mfauzansyarif/ugv-robot/dokumentasi/image (3).png

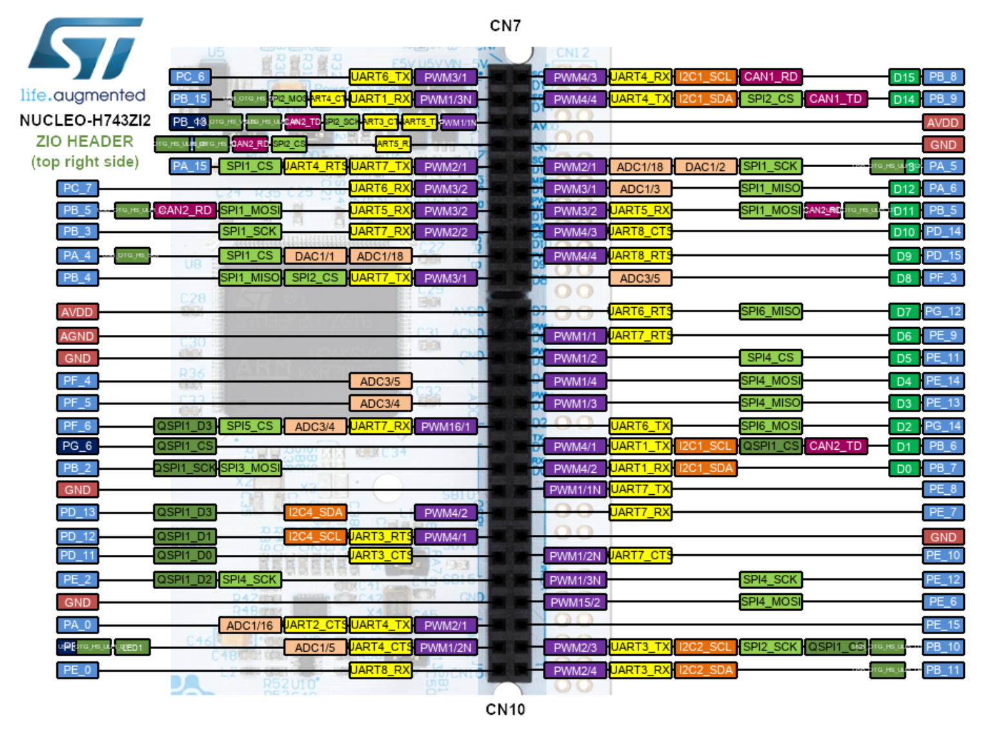
dokumentasi/image (3).png
