mfauzansyarif/ugv-robot/dokumentasi/image (2).png

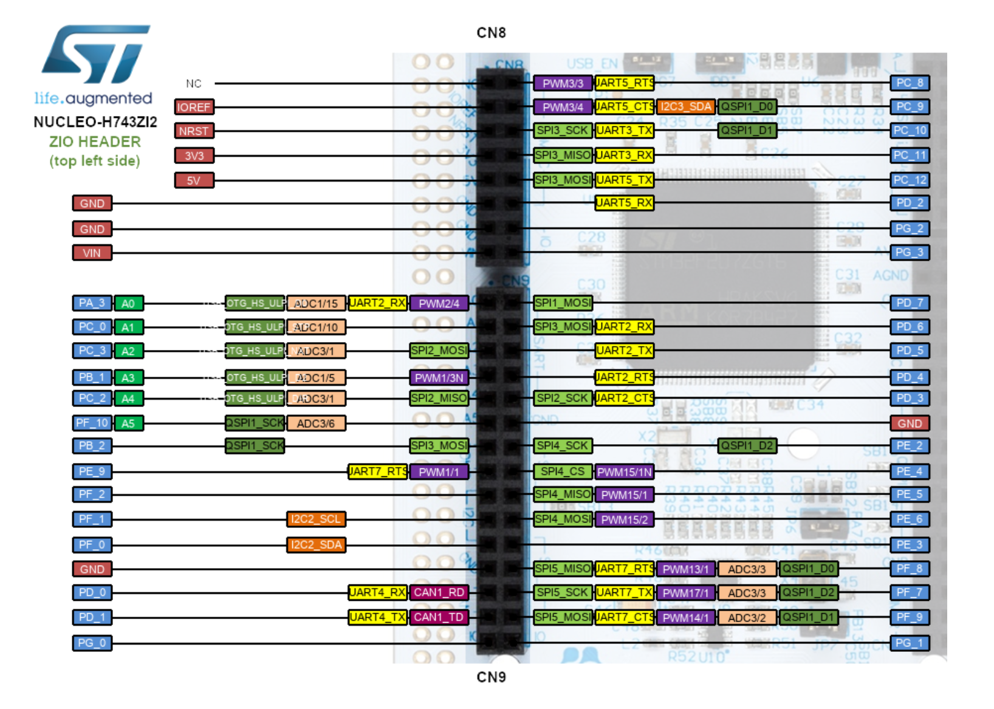
dokumentasi/image (2).png
