mfauzansyarif/ugv-robot/Hardware/GCS/LAYOUT PANEL ROBOT TERBARU.pptx

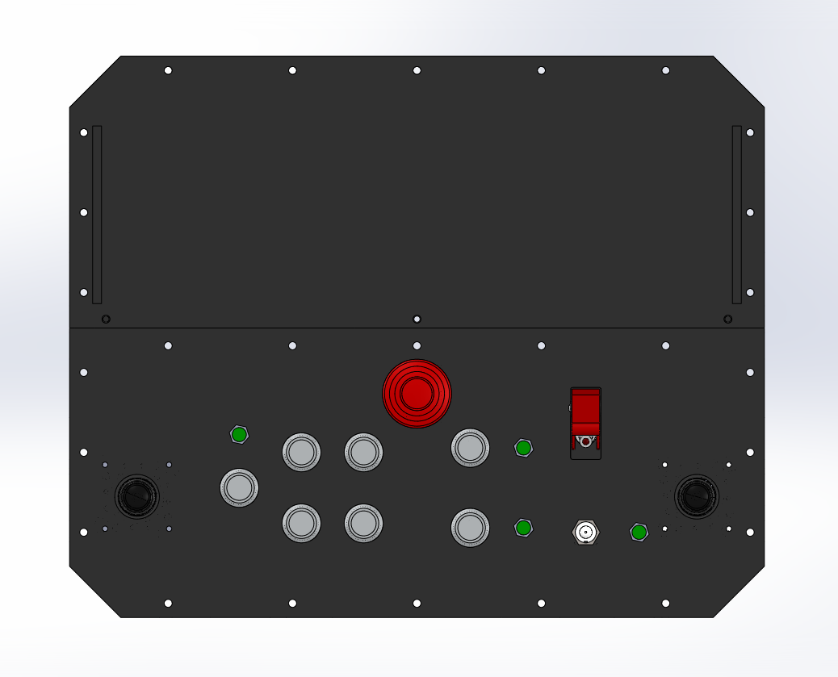
[picture p3: figure]

PENGHENTIAN DARURAT

INDIKATOR LRF

AKTIVASI & INDIKATOR DAYA

PERGERAKAN ROBOT

PERGERAKAN KAMERA

MODE MENGEMUDI + INDIKATOR

AKTIVASI LRF

PENGATURAN ZOOM

PENGATURAN FOKUS

MODE PEMOSISIAN + INDIKATOR

AKTIVASI PENERANGAN

## Slide 2

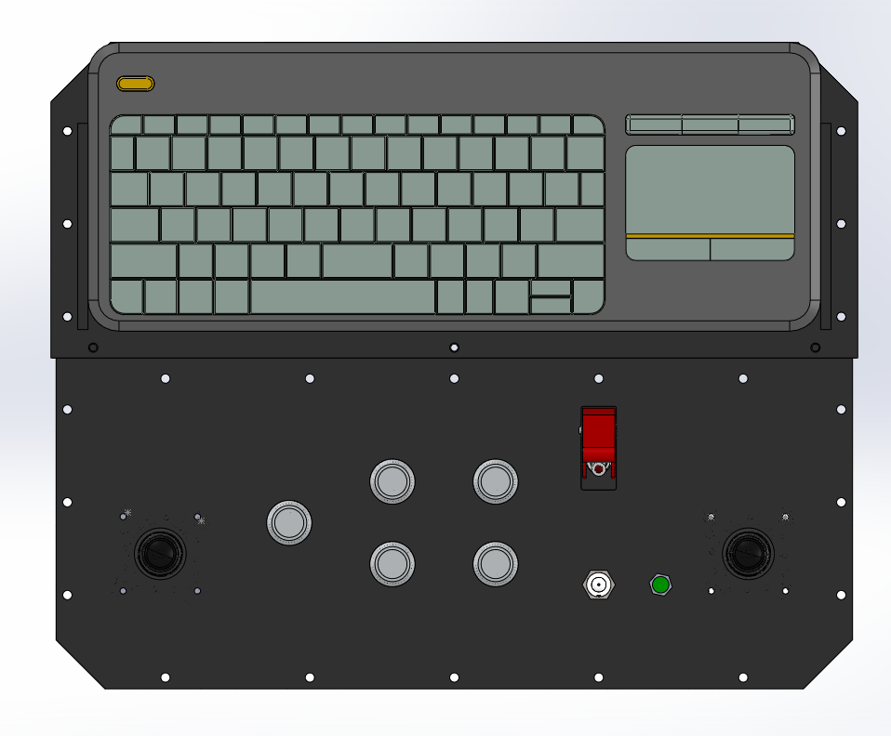
[picture p4: figure]

AKTIVASI & INDIKATOR DAYA

PERGERAKAN ROBOT

AKTIVASI LRF

PENGATURAN ZOOM

PENGATURAN FOKUS

PERGERAKAN KAMERA

AKTIVASI PENERANGAN
