mfauzansyarif/ugv-robot/dokumentasi/Gambar 1.pdf

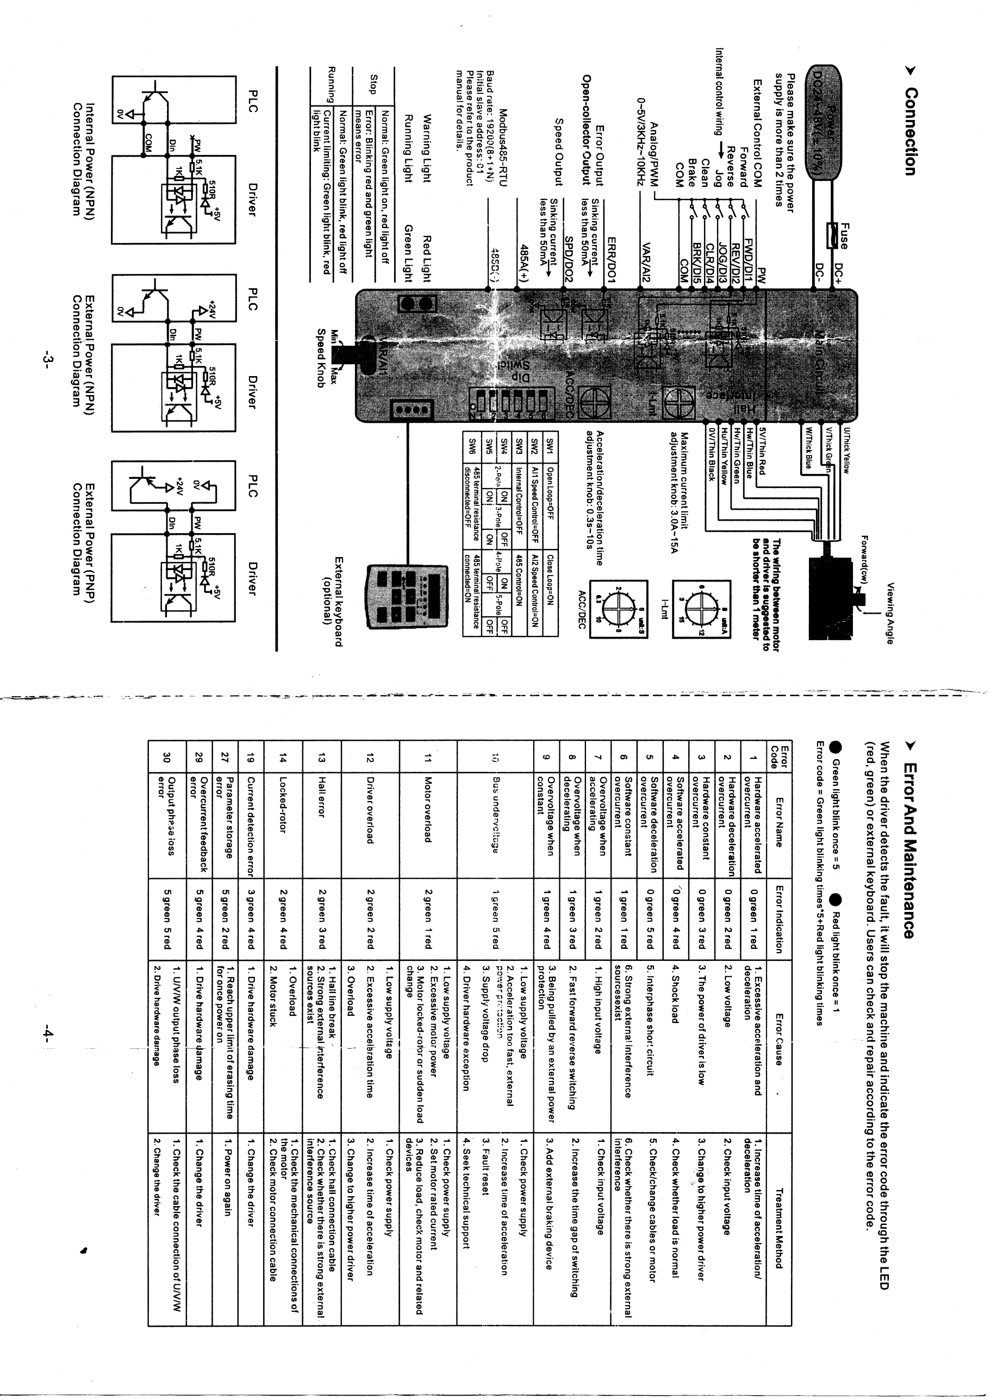
[picture p5: page 1]
