mfauzansyarif/ugv-robot/dokumentasi/Gambar 2.pdf

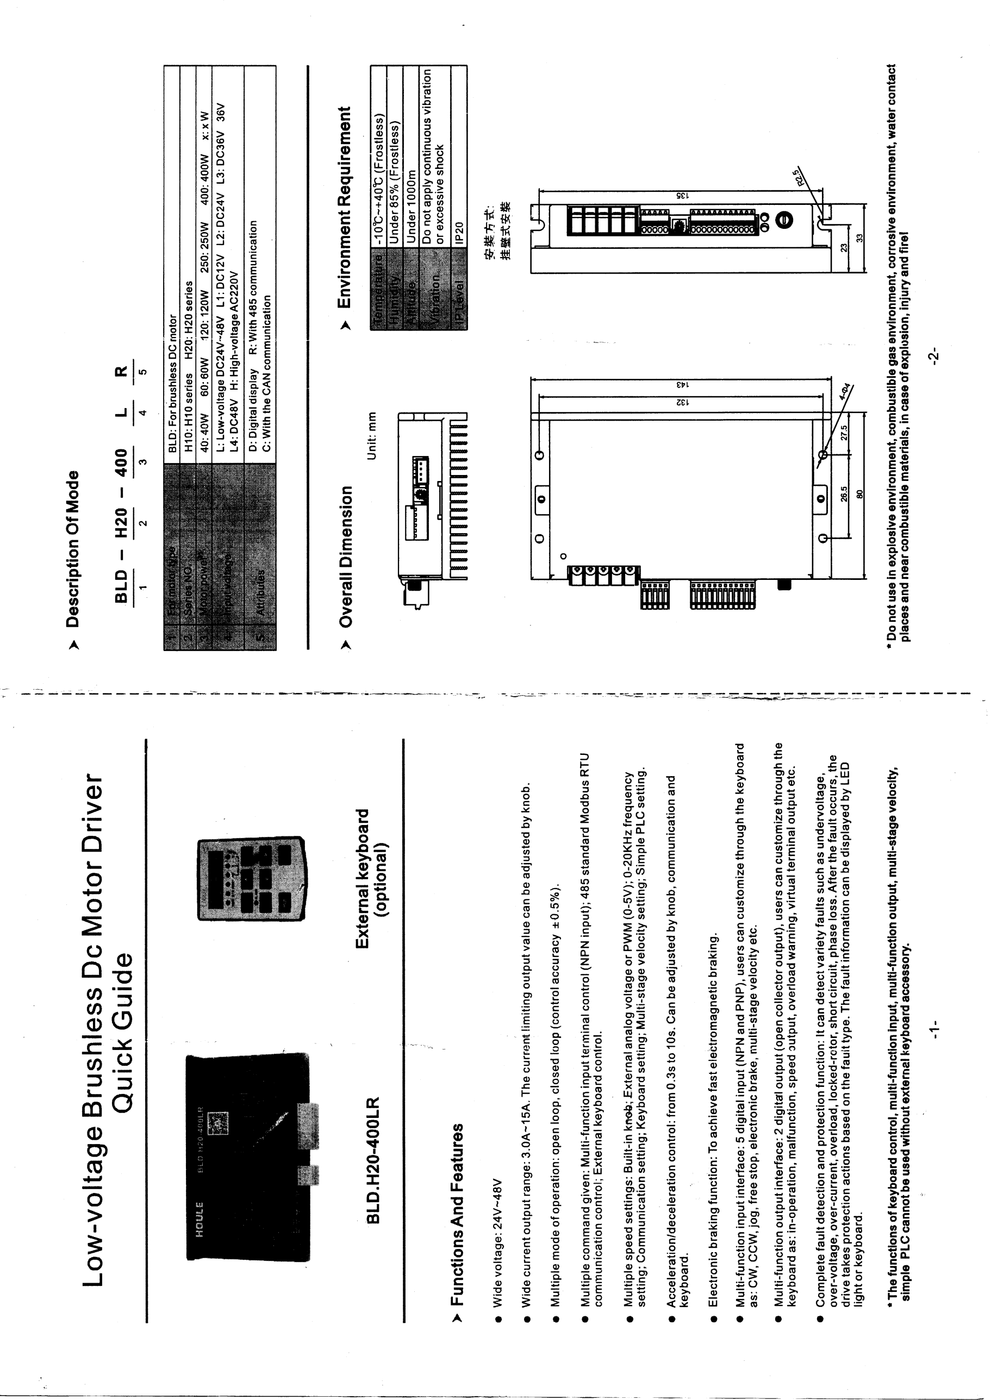
[picture p6: page 1]
