mfauzansyarif/ugv-robot/dokumentasi/Gambar 3.pdf

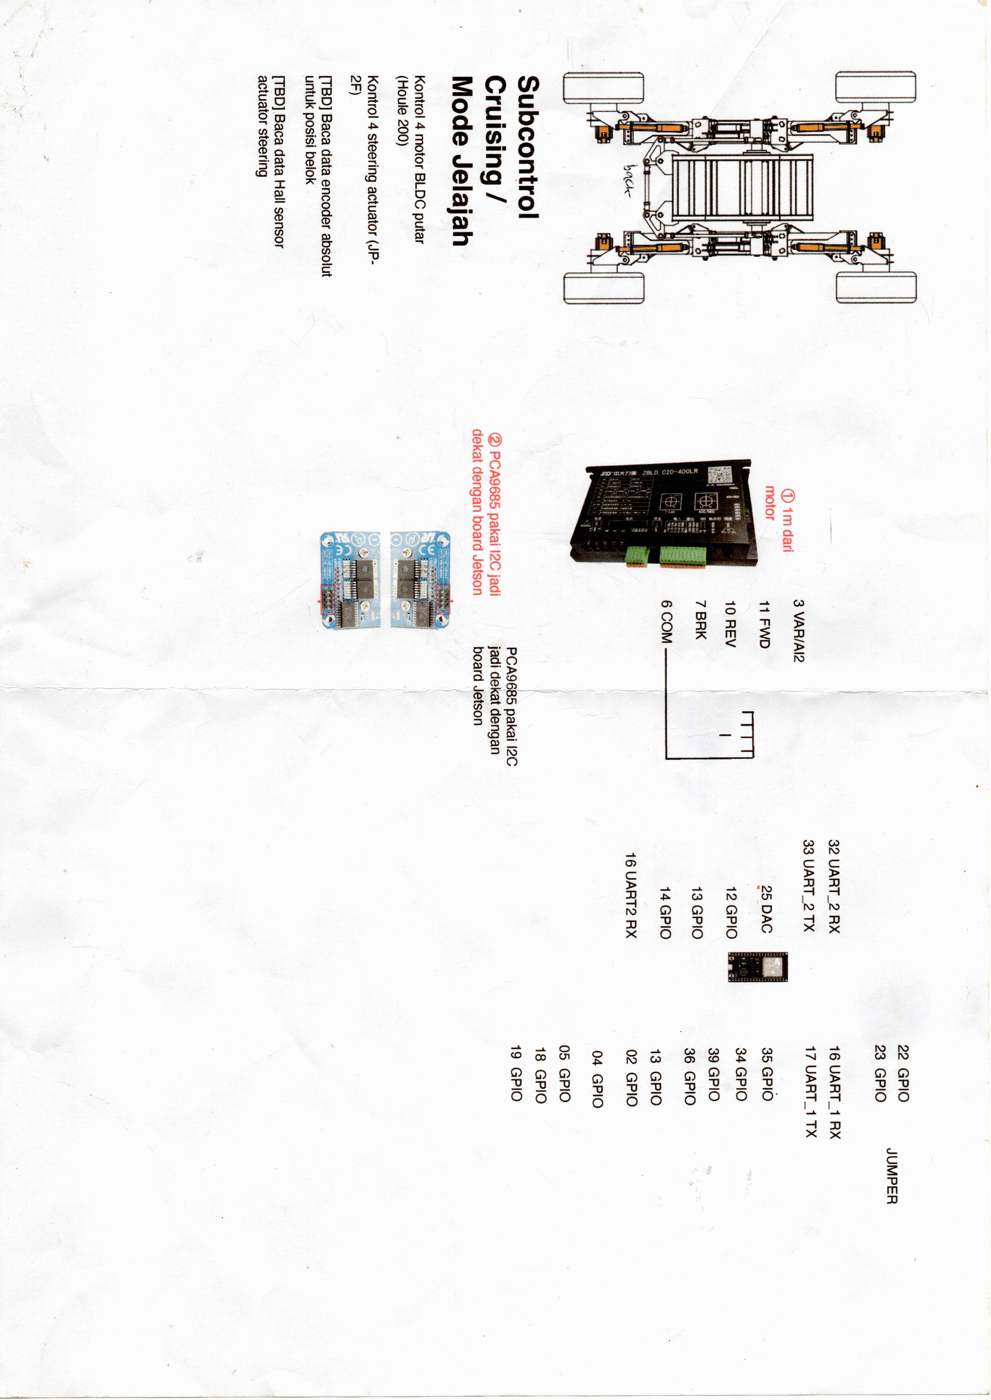
[picture p7: page 1]
