mfauzansyarif/ugv-robot/dokumentasi/1.jpeg

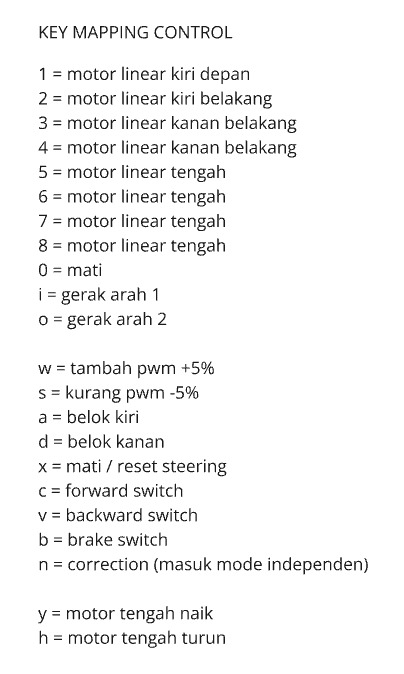
dokumentasi/1.jpeg
