mfauzansyarif/ugv-robot/dokumentasi/2.jpeg

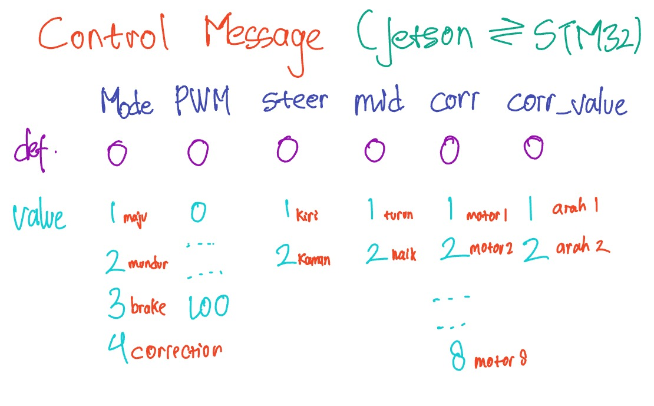
dokumentasi/2.jpeg
