mfauzansyarif/ugv-robot/dokumentasi/3.jpeg

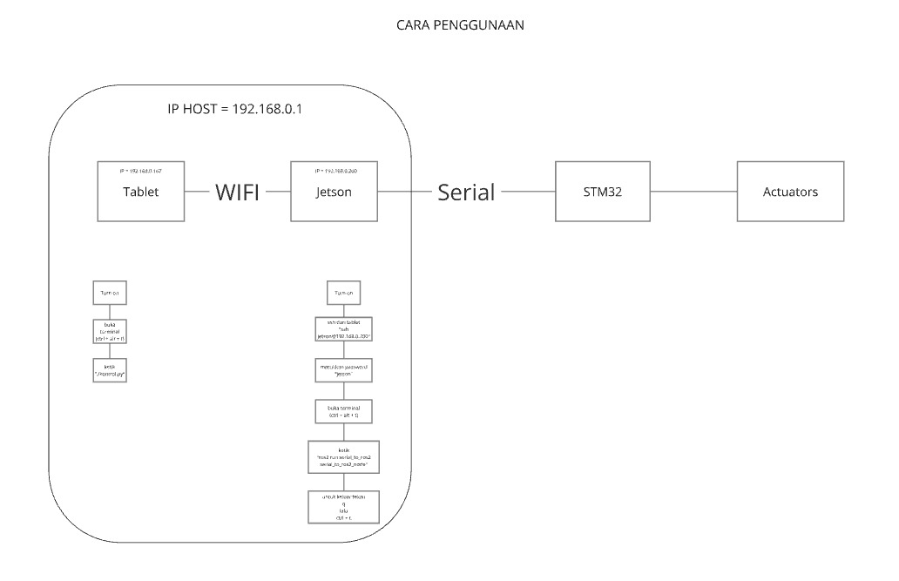
dokumentasi/3.jpeg
