mfauzansyarif/ugv-robot/dokumentasi/4.jpeg

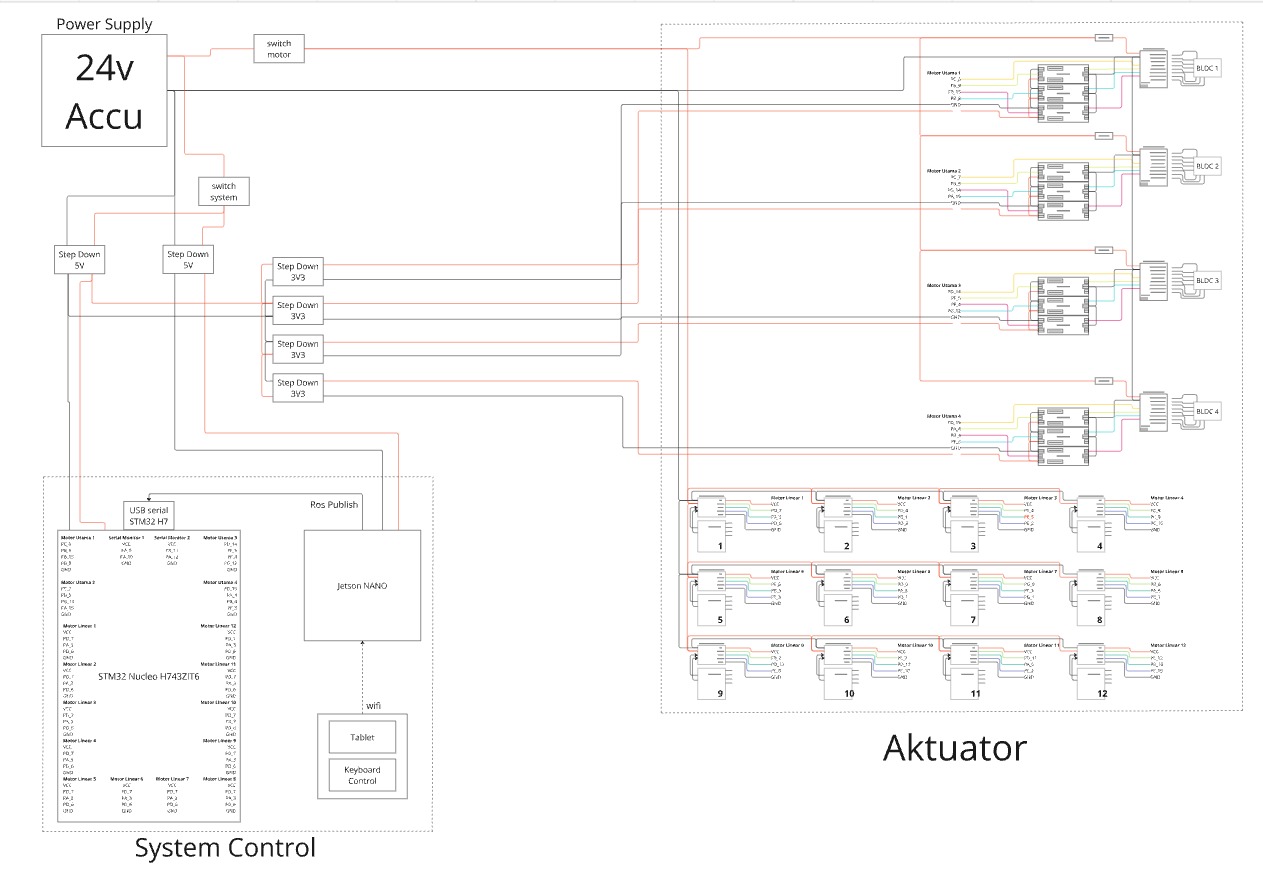
dokumentasi/4.jpeg
