mfauzansyarif/ugv-robot/dokumentasi/5.jpeg

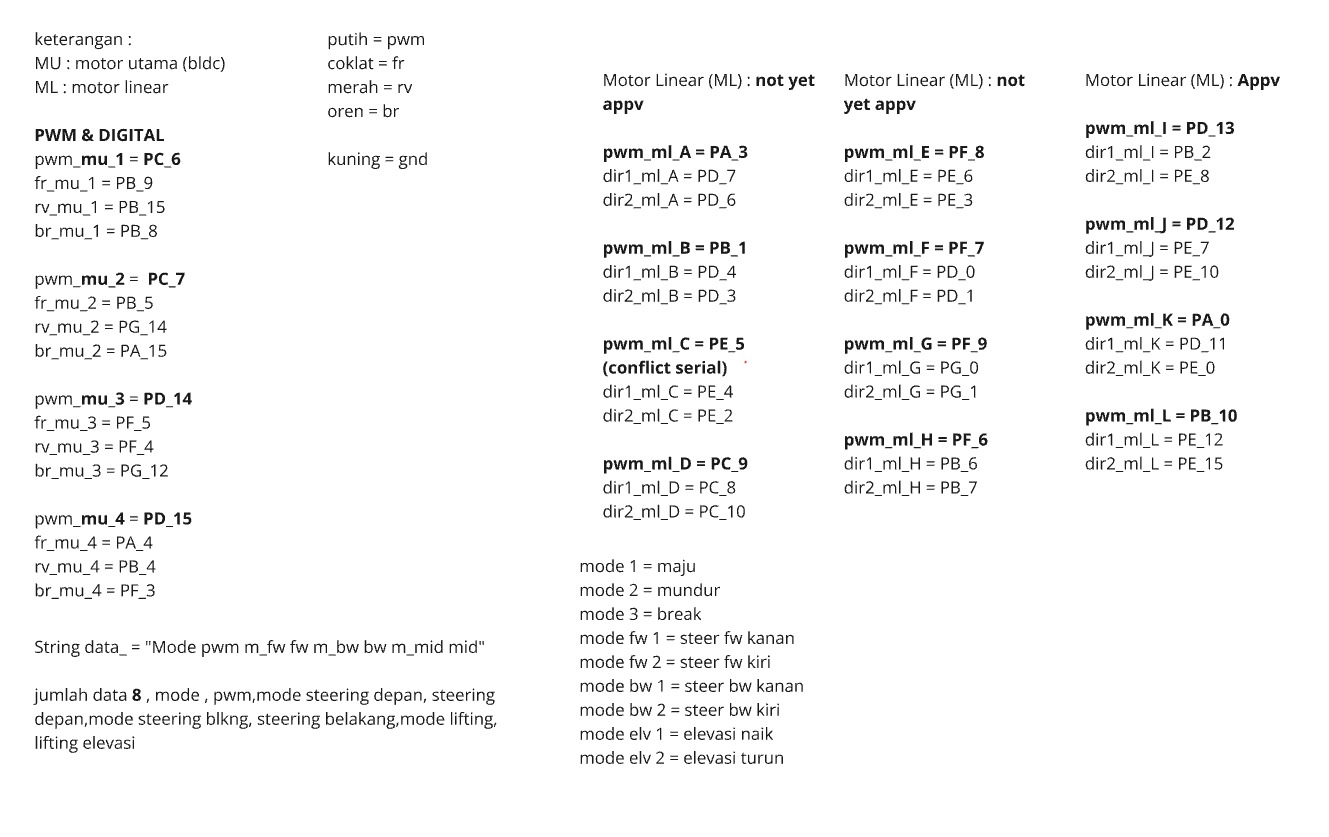
dokumentasi/5.jpeg
