mfauzansyarif/ugv-robot/Dokumentasi/Block Diagram.png

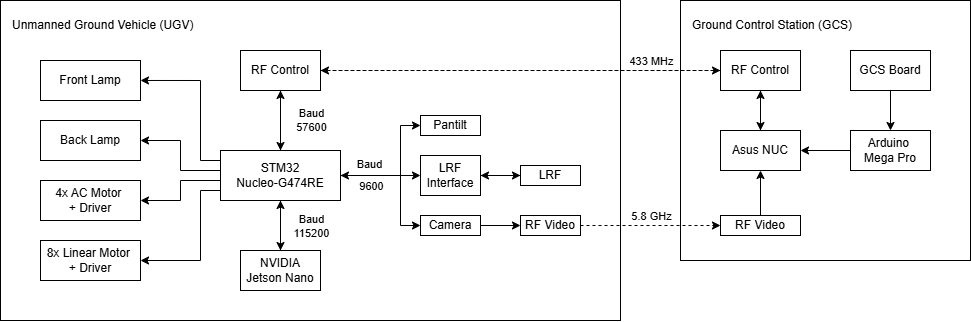
Dokumentasi/Block Diagram.png
