mfauzansyarif/ugv-robot/dokumentasi/board.png

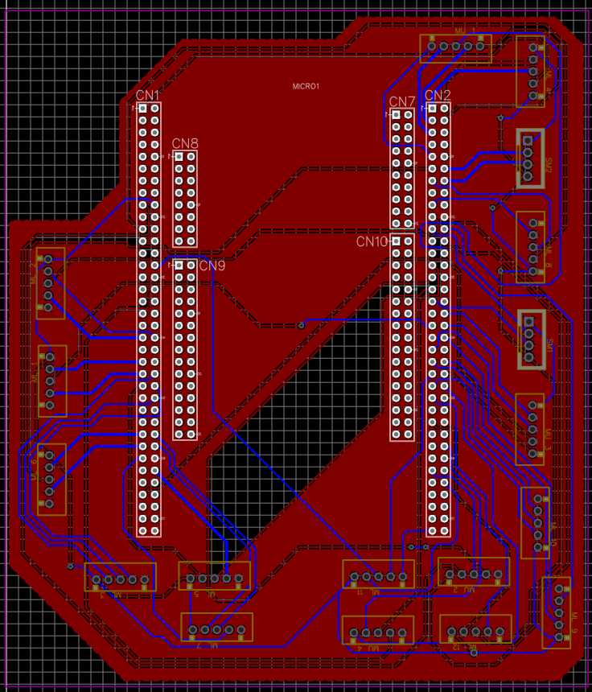
dokumentasi/board.png
