mfauzansyarif/ugv-robot/dokumentasi/boardrot.png

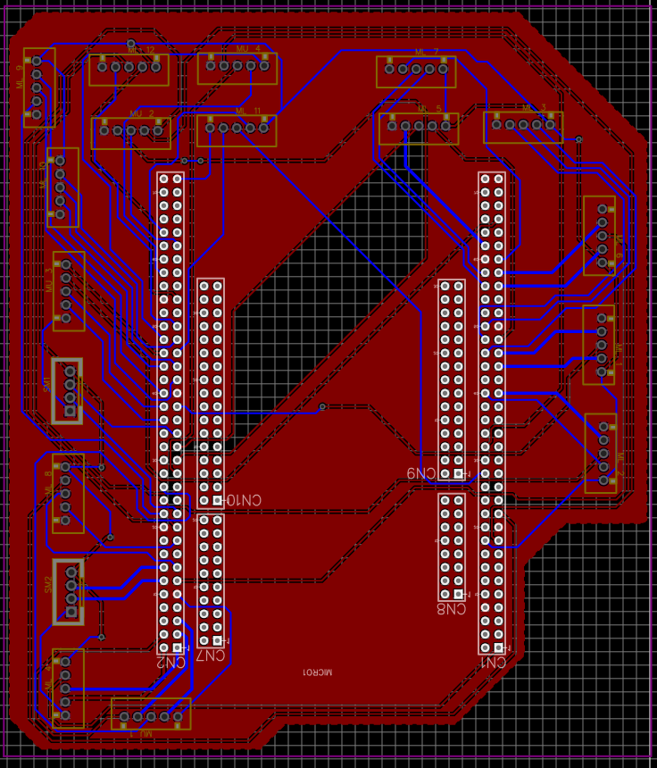
dokumentasi/boardrot.png
