mfauzansyarif/ugv-robot/dokumentasi/Finished/1.jpg

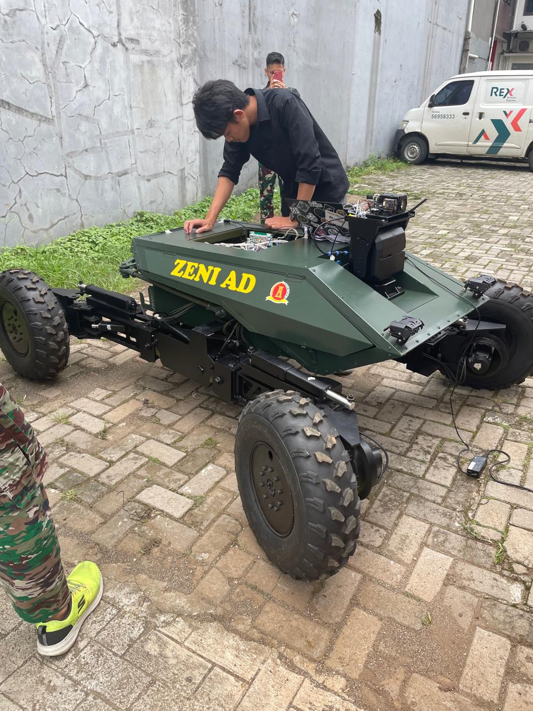
dokumentasi/Finished/1.jpg
