mfauzansyarif/ugv-robot/dokumentasi/Finished/2.jpg

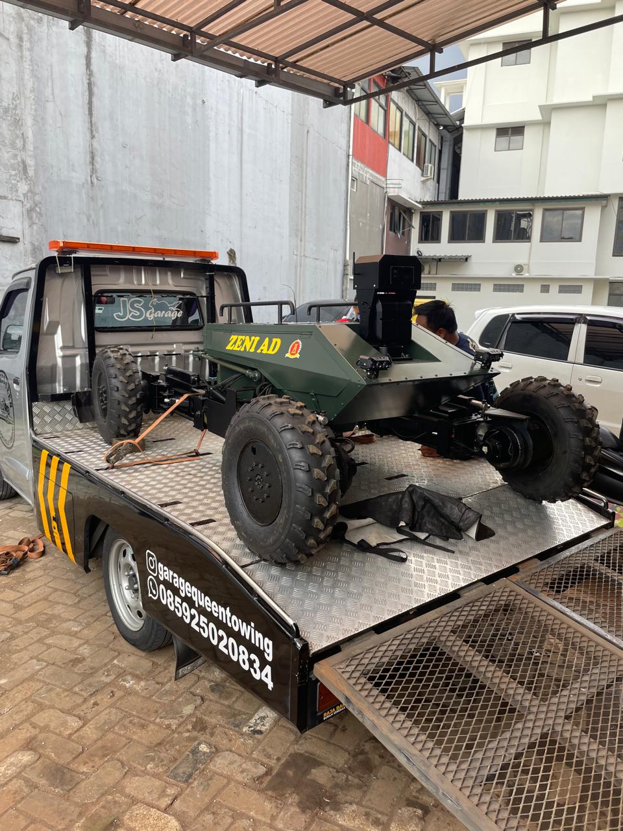
dokumentasi/Finished/2.jpg
