mfauzansyarif/ugv-robot/dokumentasi/Finished/3.jpg

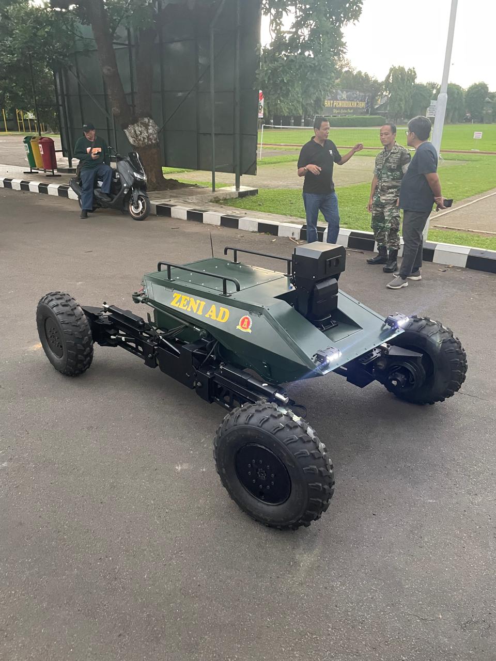
dokumentasi/Finished/3.jpg
