mfauzansyarif/ugv-robot/dokumentasi/Finished/Tampilan GCS.jpg

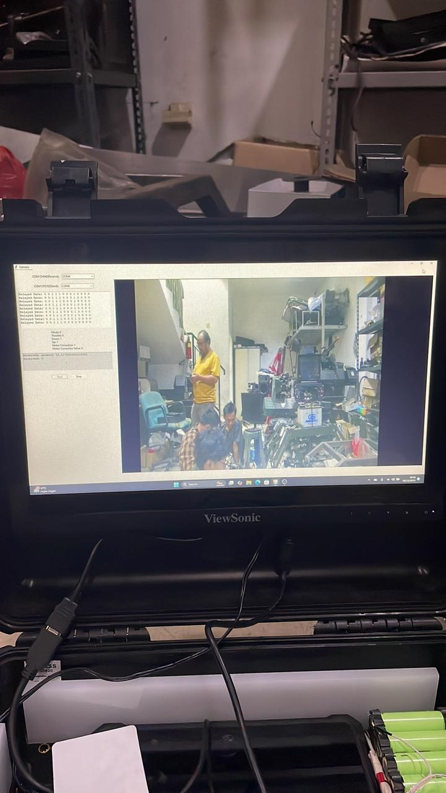
dokumentasi/Finished/Tampilan GCS.jpg
