mfauzansyarif/ugv-robot/dokumentasi/Finished/Video Channel.jpg

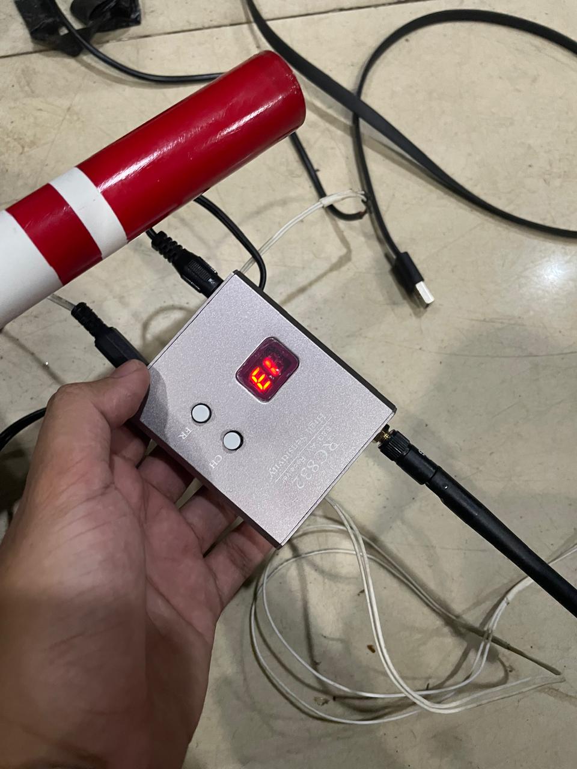
dokumentasi/Finished/Video Channel.jpg
