mfauzansyarif/ugv-robot/dokumentasi/flowchart ros.jpeg

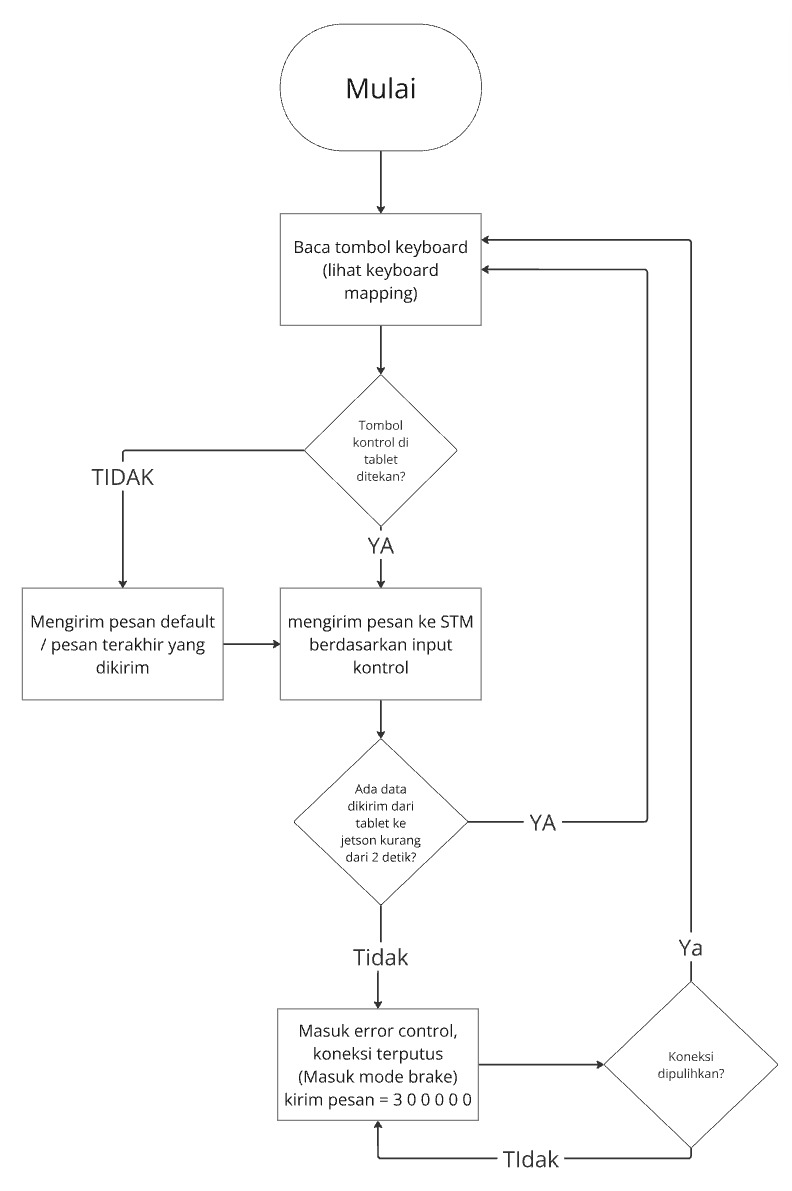
dokumentasi/flowchart ros.jpeg
