mfauzansyarif/ugv-robot/dokumentasi/flowchart_micro.jpeg

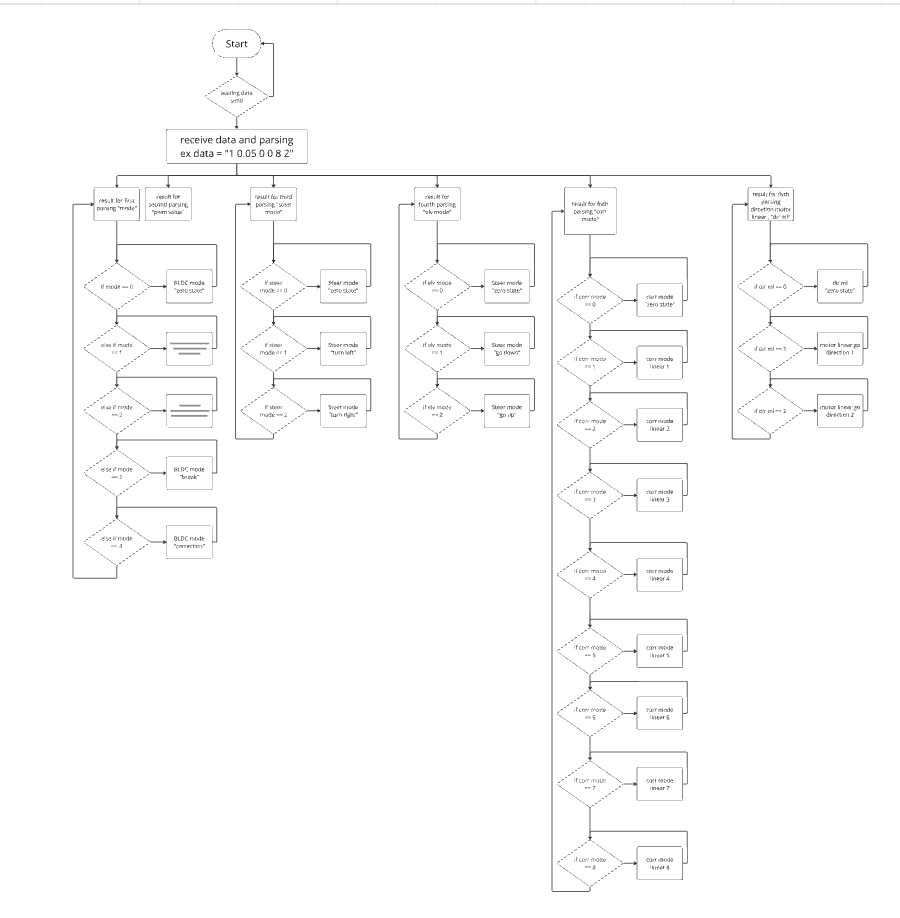
dokumentasi/flowchart_micro.jpeg
