mfauzansyarif/ugv-robot/dokumentasi/image (1).png

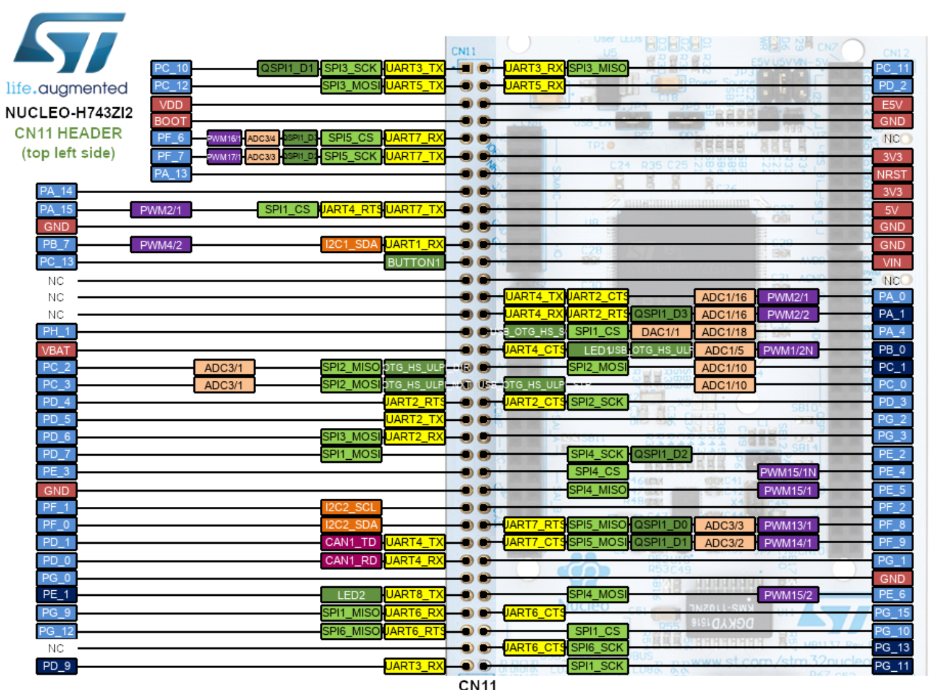
dokumentasi/image (1).png
