mfauzansyarif/ugv-robot/dokumentasi/image (4).png

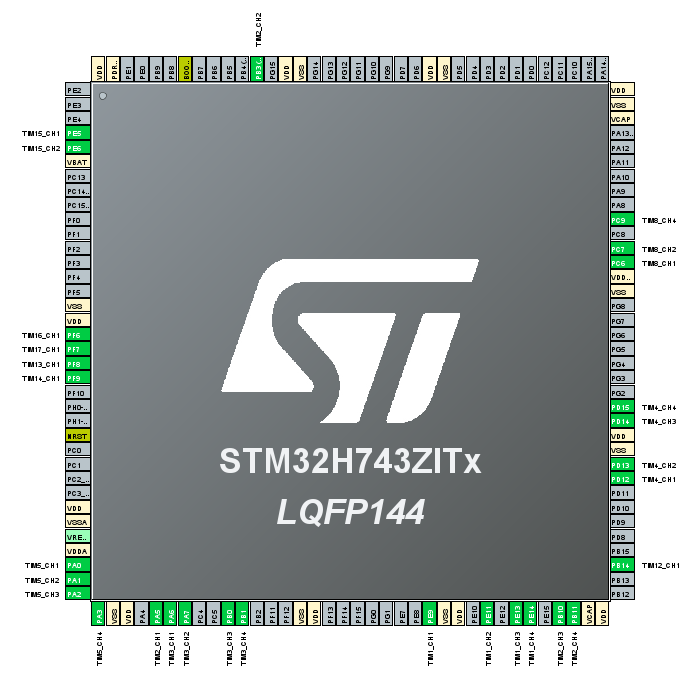
dokumentasi/image (4).png
