mfauzansyarif/ugv-robot/dokumentasi/image-4196345427236762729.jpg

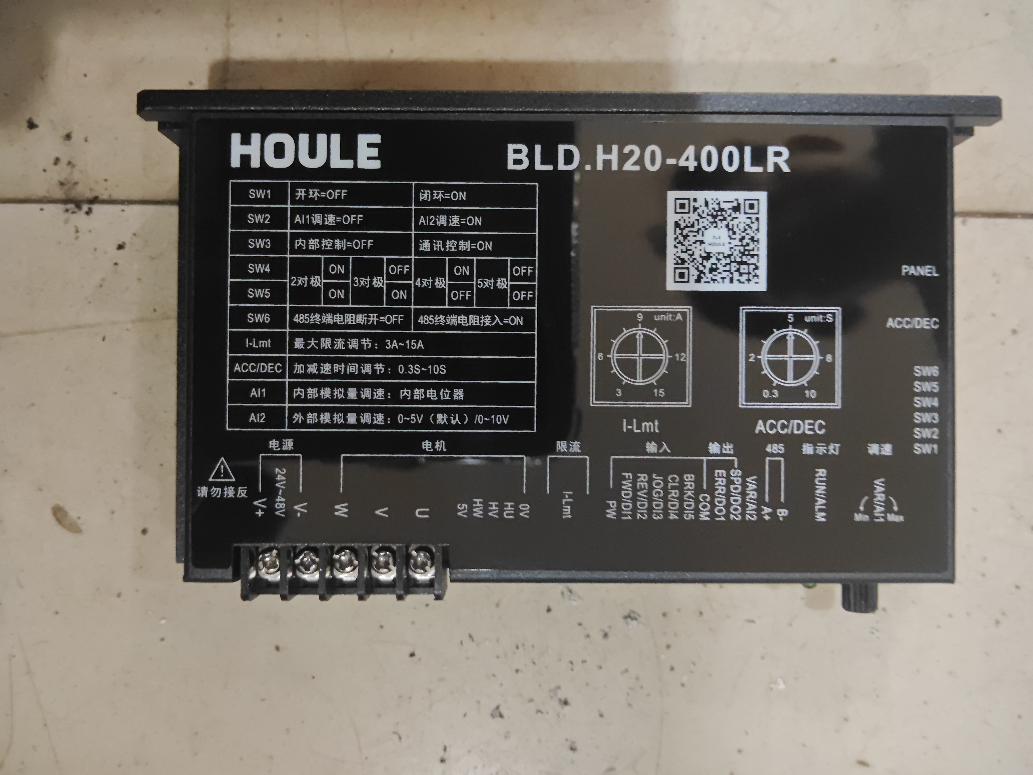
dokumentasi/image-4196345427236762729.jpg
