mfauzansyarif/ugv-robot/dokumentasi/image.png

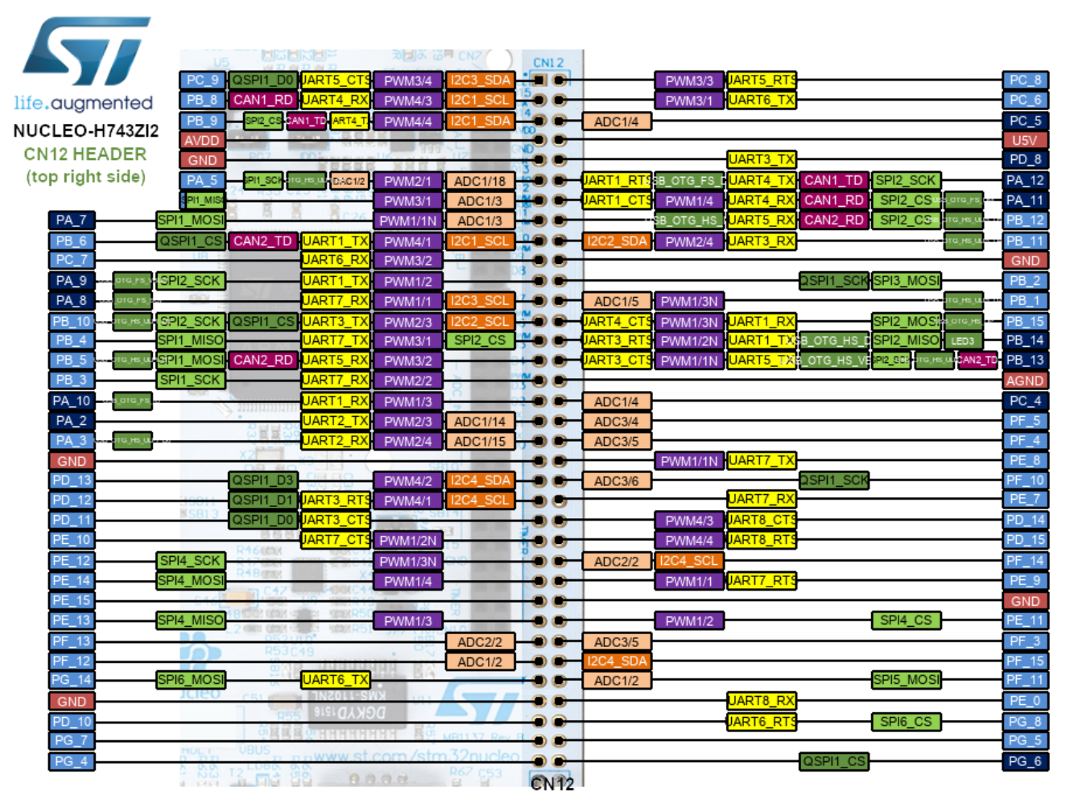
dokumentasi/image.png
