mfauzansyarif/ugv-robot/dokumentasi/IMG-20241010-WA0011.jpg

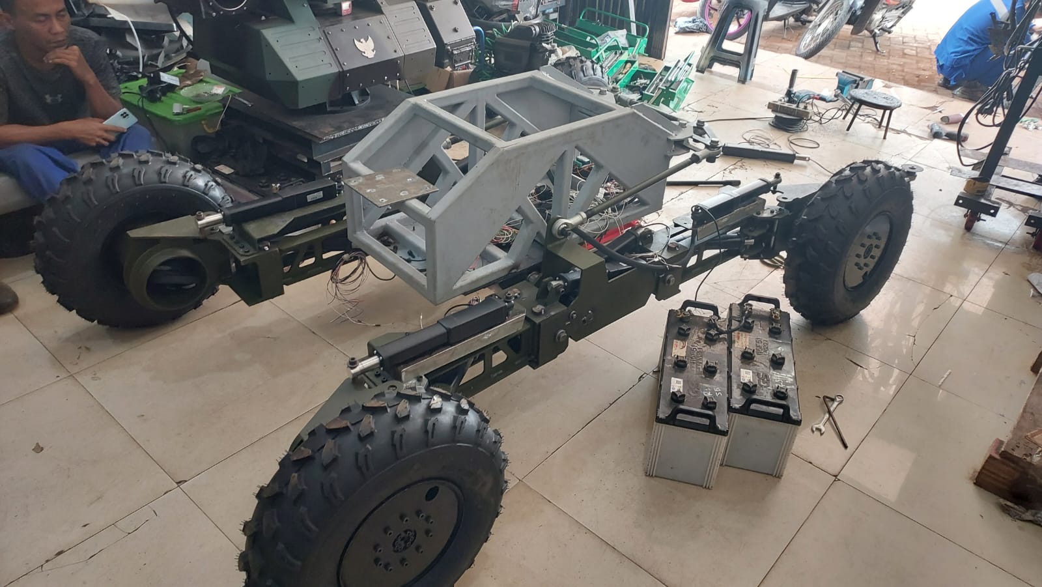
dokumentasi/IMG-20241010-WA0011.jpg
