mfauzansyarif/ugv-robot/dokumentasi/IMG-20241016-WA0005.jpg

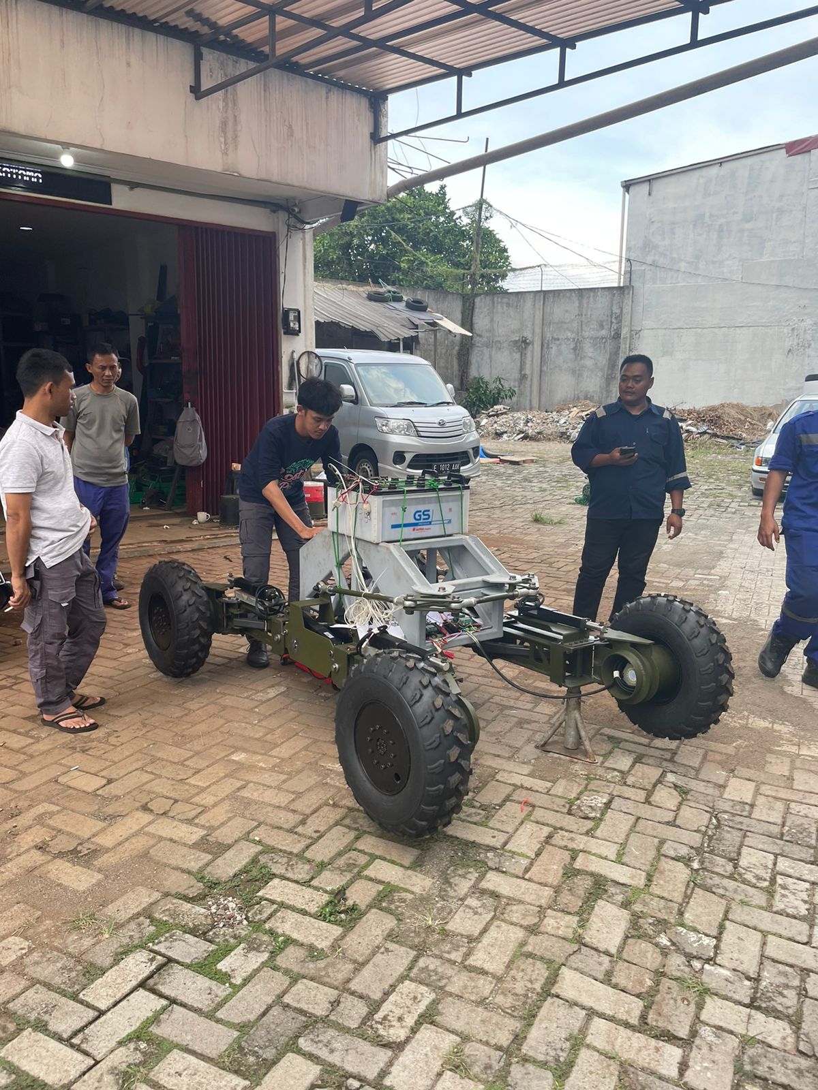
dokumentasi/IMG-20241016-WA0005.jpg
