mfauzansyarif/ugv-robot/dokumentasi/IMG-20241016-WA0006.jpg

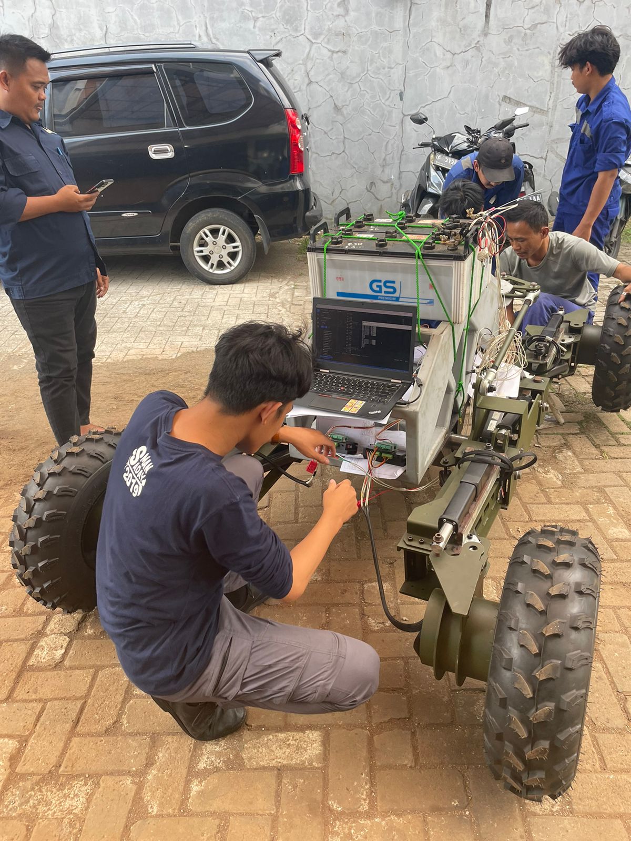
dokumentasi/IMG-20241016-WA0006.jpg
