mfauzansyarif/ugv-robot/dokumentasi/komponenTerpilih/63565f83d05fbe7b79015e82-songhe-dc-1-channel-optocoupler-3v-3-3v.jpg

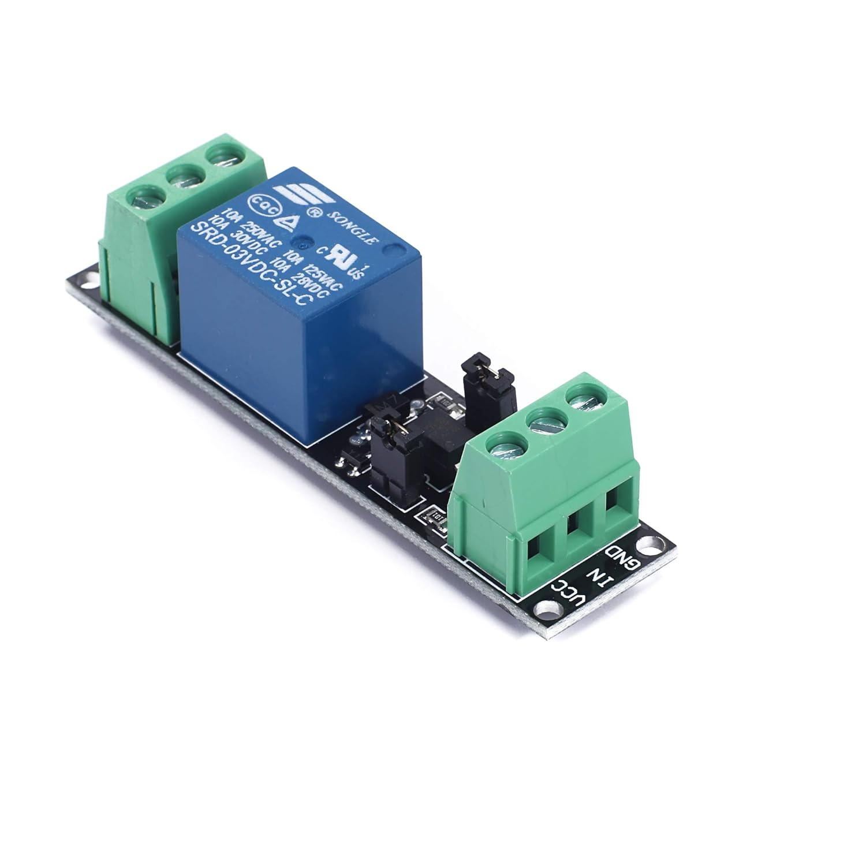
dokumentasi/komponenTerpilih/63565f83d05fbe7b79015e82-songhe-dc-1-channel-optocoupler-3v-3-3v.jpg
