mfauzansyarif/ugv-robot/dokumentasi/komponenTerpilih/jetsonnano.jpg

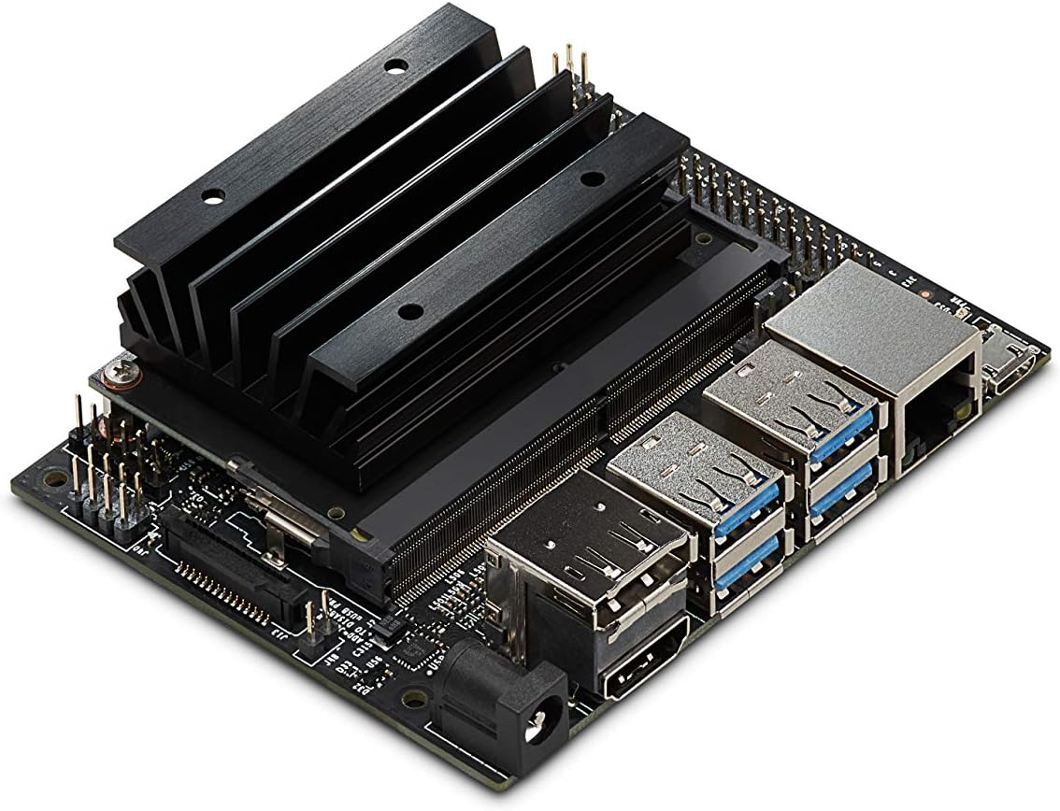
dokumentasi/komponenTerpilih/jetsonnano.jpg
