mfauzansyarif/ugv-robot/dokumentasi/komponenTerpilih/xl4015.jpg

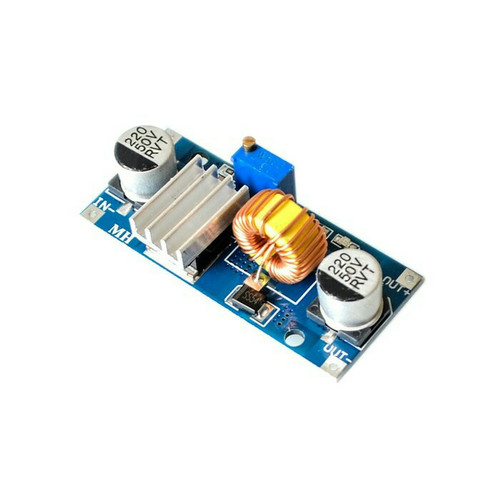
dokumentasi/komponenTerpilih/xl4015.jpg
