mfauzansyarif/ugv-robot/dokumentasi/option1.jpeg

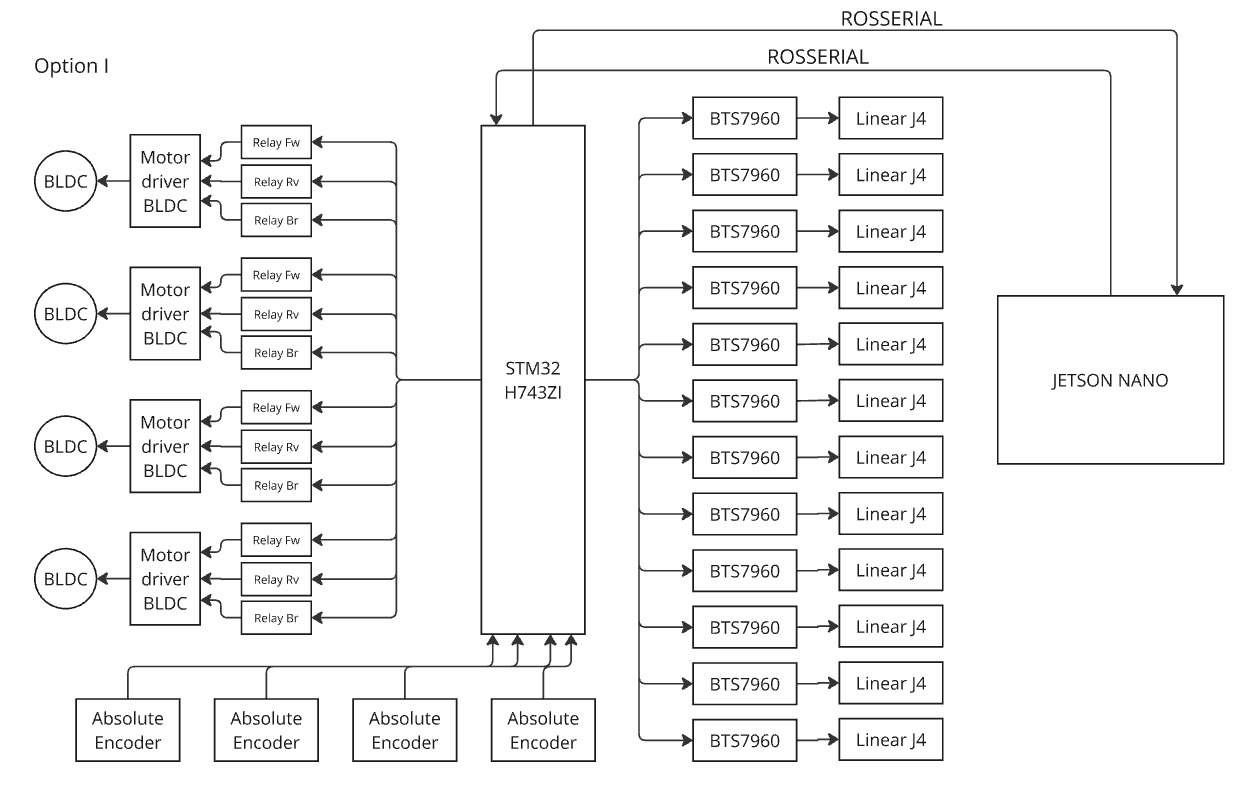
dokumentasi/option1.jpeg
