mfauzansyarif/ugv-robot/dokumentasi/option2.jpeg

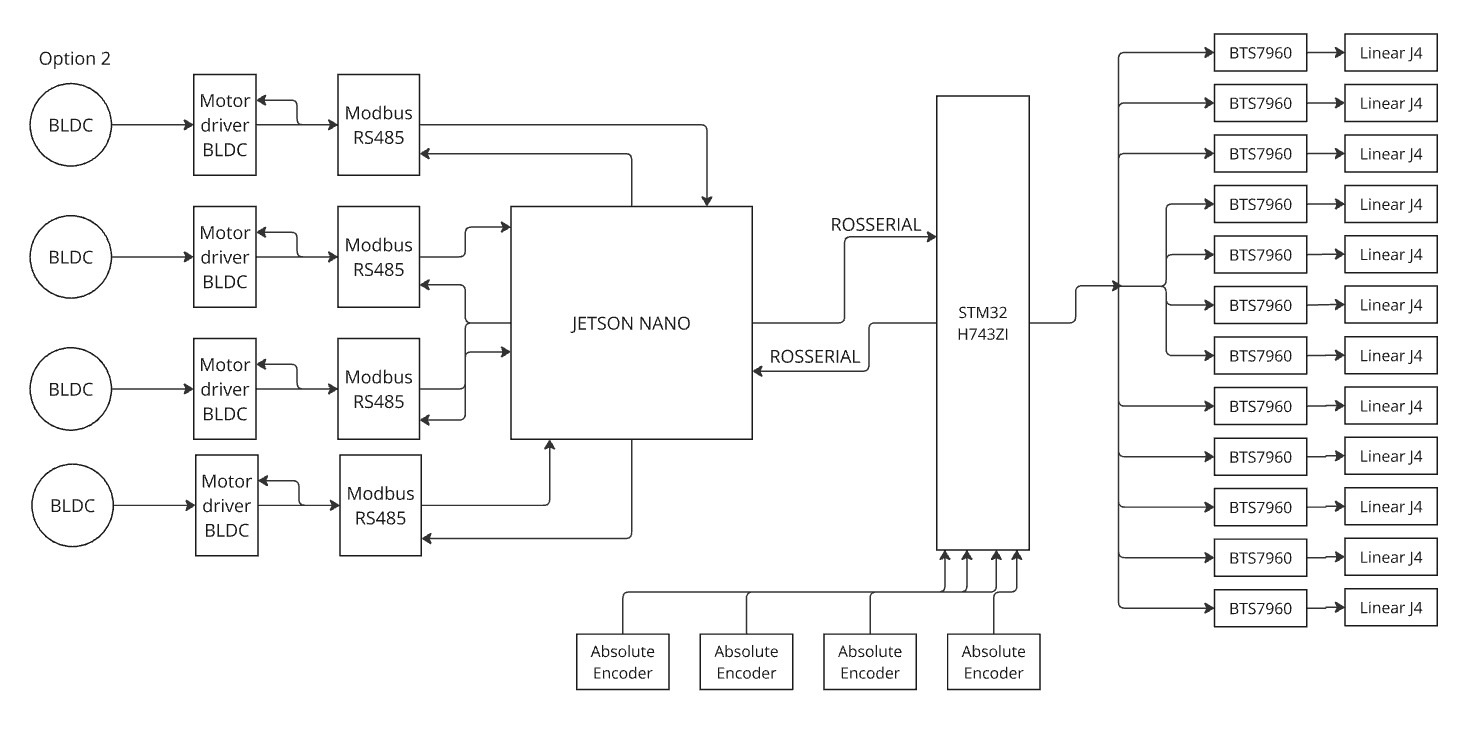
dokumentasi/option2.jpeg
