mfauzansyarif/ugv-robot/dokumentasi/sketch.png

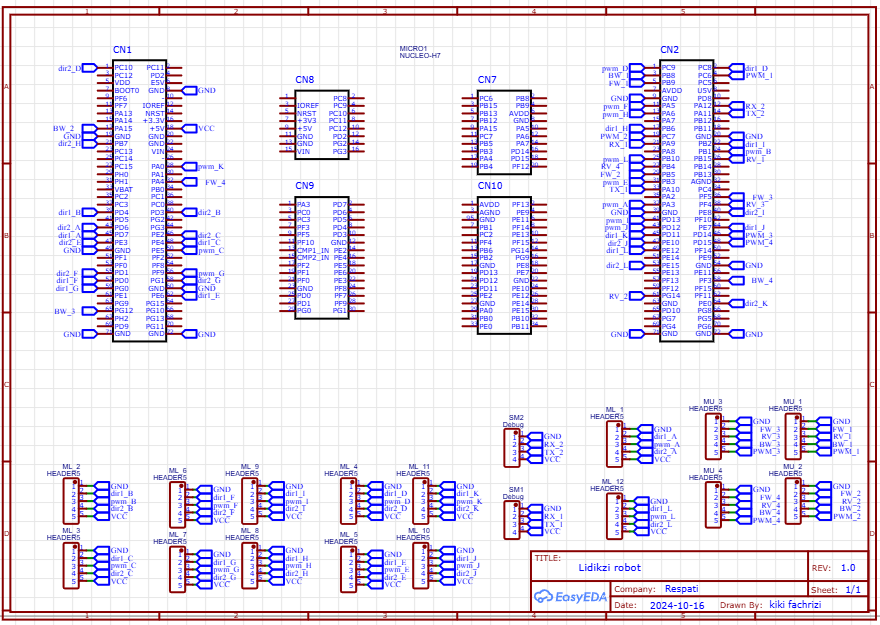
dokumentasi/sketch.png
