mfauzansyarif/ugv-robot/dokumentasi/List PINOUT/wiring_motor_blac.xlsx

Sheet: Wiring Motor BLAC
Motor | PIN STM32 | PIN Driver | Warna Kabel | Catatan
Kiri Belakang | PA5 | SIGN+ | Ungu
Kiri Belakang | PF12 | PULS+ | Abu
Kiri Belakang | GND | PULS- | Ijo
Kiri Belakang | GND | SIGN- | Item
Kiri Belakang | (tidak konek) | SON | Biru
Kiri Belakang | (tidak konek) | COM+ | Putih
Kanan Belakang | PB4 | PULS+ | Abu
Kanan Belakang | PA4 | SIGN+ | Ungu
Kanan Belakang | GND | PULS- | Coklat
Kanan Belakang | GND | SIGN- | Item
Kanan Belakang | (tidak konek) | SON | Biru
Kanan Belakang | (tidak konek) | COM+ | Putih
Kiri Depan | PF13 | SIGN+ | Ungu
Kiri Depan | PD14 | PULS+ | Abu
Kiri Depan | GND | PULS- | Coklat
Kiri Depan | GND | SIGN- | Item
Kiri Depan | (tidak konek) | SON | Biru
Kiri Depan | (tidak konek) | COM+ | Putih
Kanan Depan | PB8 | SIGN+ | Ungu
Kanan Depan | PC6 | PULS+ | Abu
Kanan Depan | PB9 | Relay | Putih | belum tau fungsinya, di-hold dulu
Kanan Depan | GND | PULS- | Coklat
Kanan Depan | GND | SIGN- | Item
Kanan Depan | (tidak konek) | SON | Biru
Kanan Depan | (tidak konek) | COM+ | Putih

Sheet: Ringkasan PULS-SIGN
Motor | PULS Pin | SIGN Pin
Kiri Belakang | PF12 | PA5
Kanan Belakang | PB4 | PA4
Kiri Depan | PD14 | PF13
Kanan Depan | PC6 | PB8
