mfauzansyarif/ugv-robot/Schematic/GCS Schematic.pdf

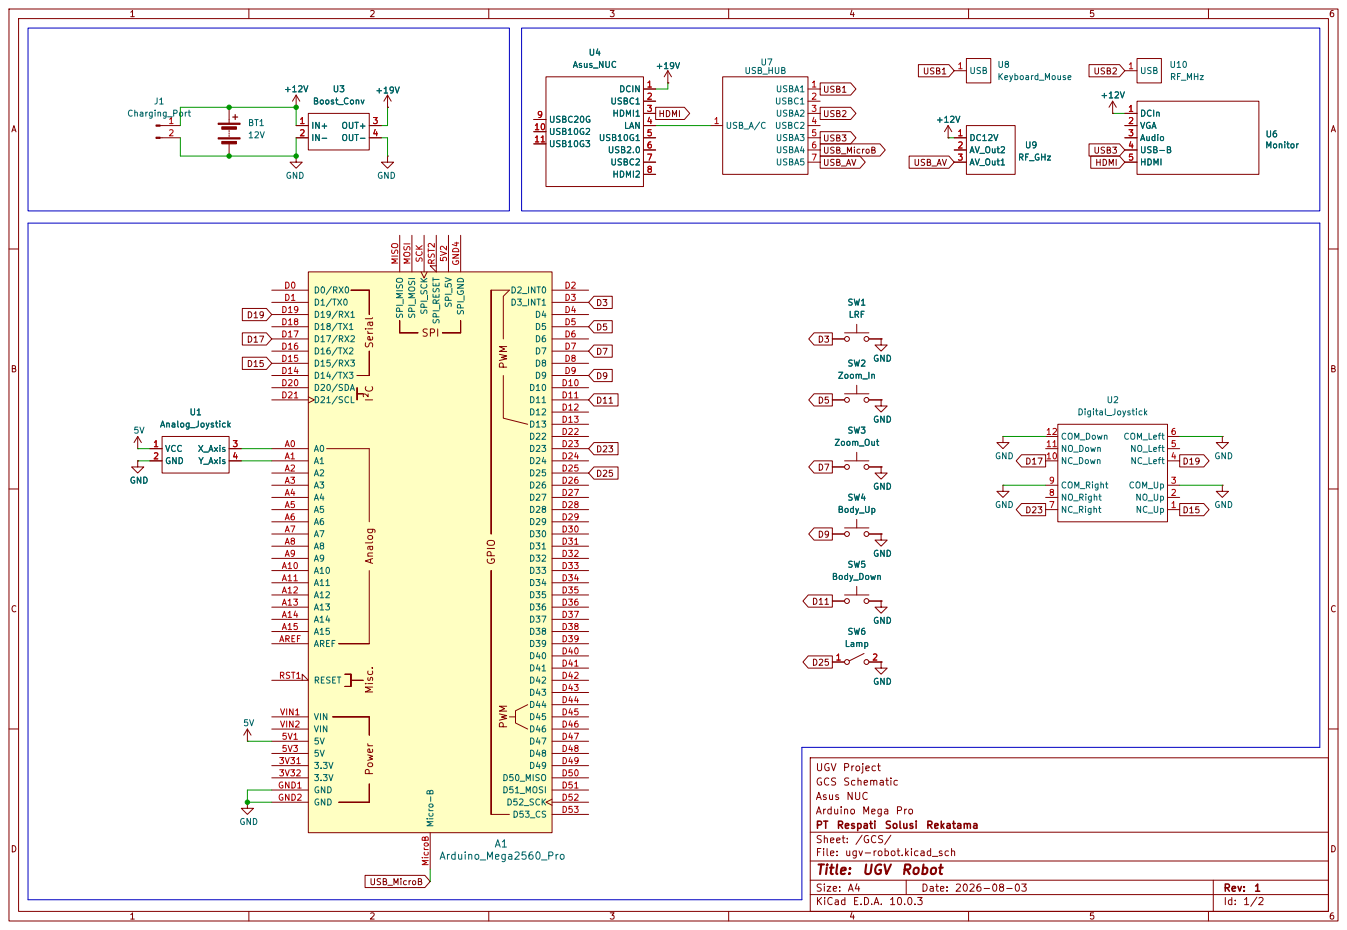
[picture p36: page 1]

UGV Project
GCS Schematic
Asus NUC
Arduino Mega Pro
PT Respati Solusi Rekatama
Sheet: /GCS/
File: ugv-robot.kicad_sch
Title: UGV Robot

Size: A4 | Rev: 1
KiCad E.D.A. 10.0.3 | Id: 1/2
