mfauzansyarif/ugv-robot/Schematic/STM32G474 Board.pdf

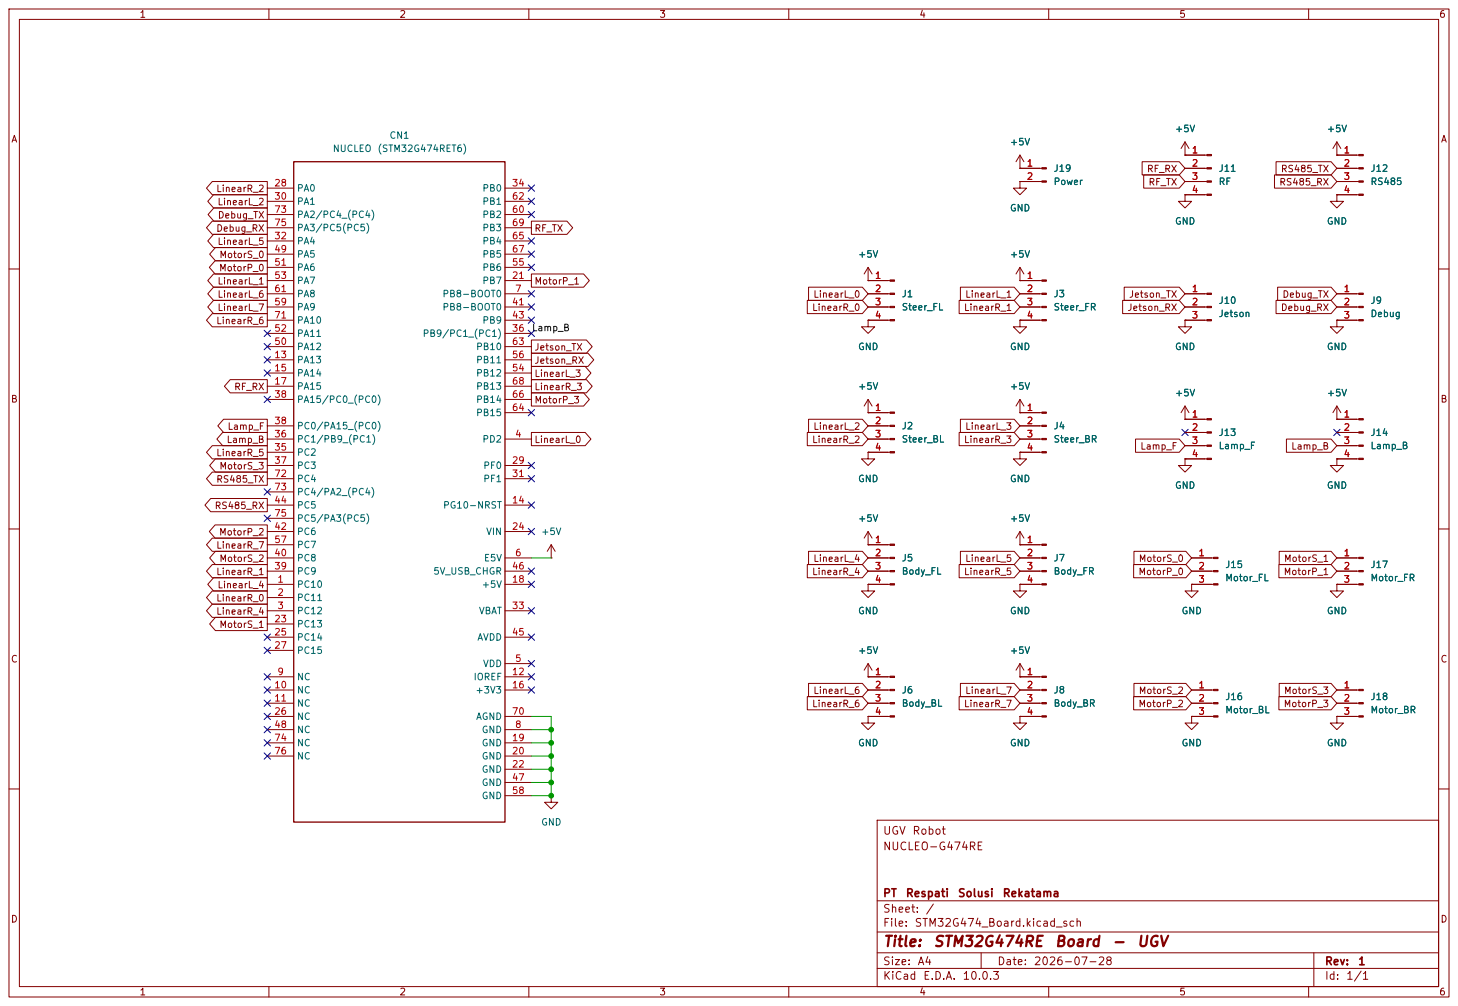
[picture p37: page 1]

PT Respati Solusi Rekatama
Sheet: /
File: STM32G474_Board.kicad_sch
Title: STM32G474RE Board - UGV

Size: A4 | Rev: 1
KiCad E.D.A. 10.0.3 | Id: 1/1
