mfauzansyarif/ugv-robot/Hardware/GCS/ROBOT - [DRW-PART] UNTUK UV PRINT [VER.2].PDF

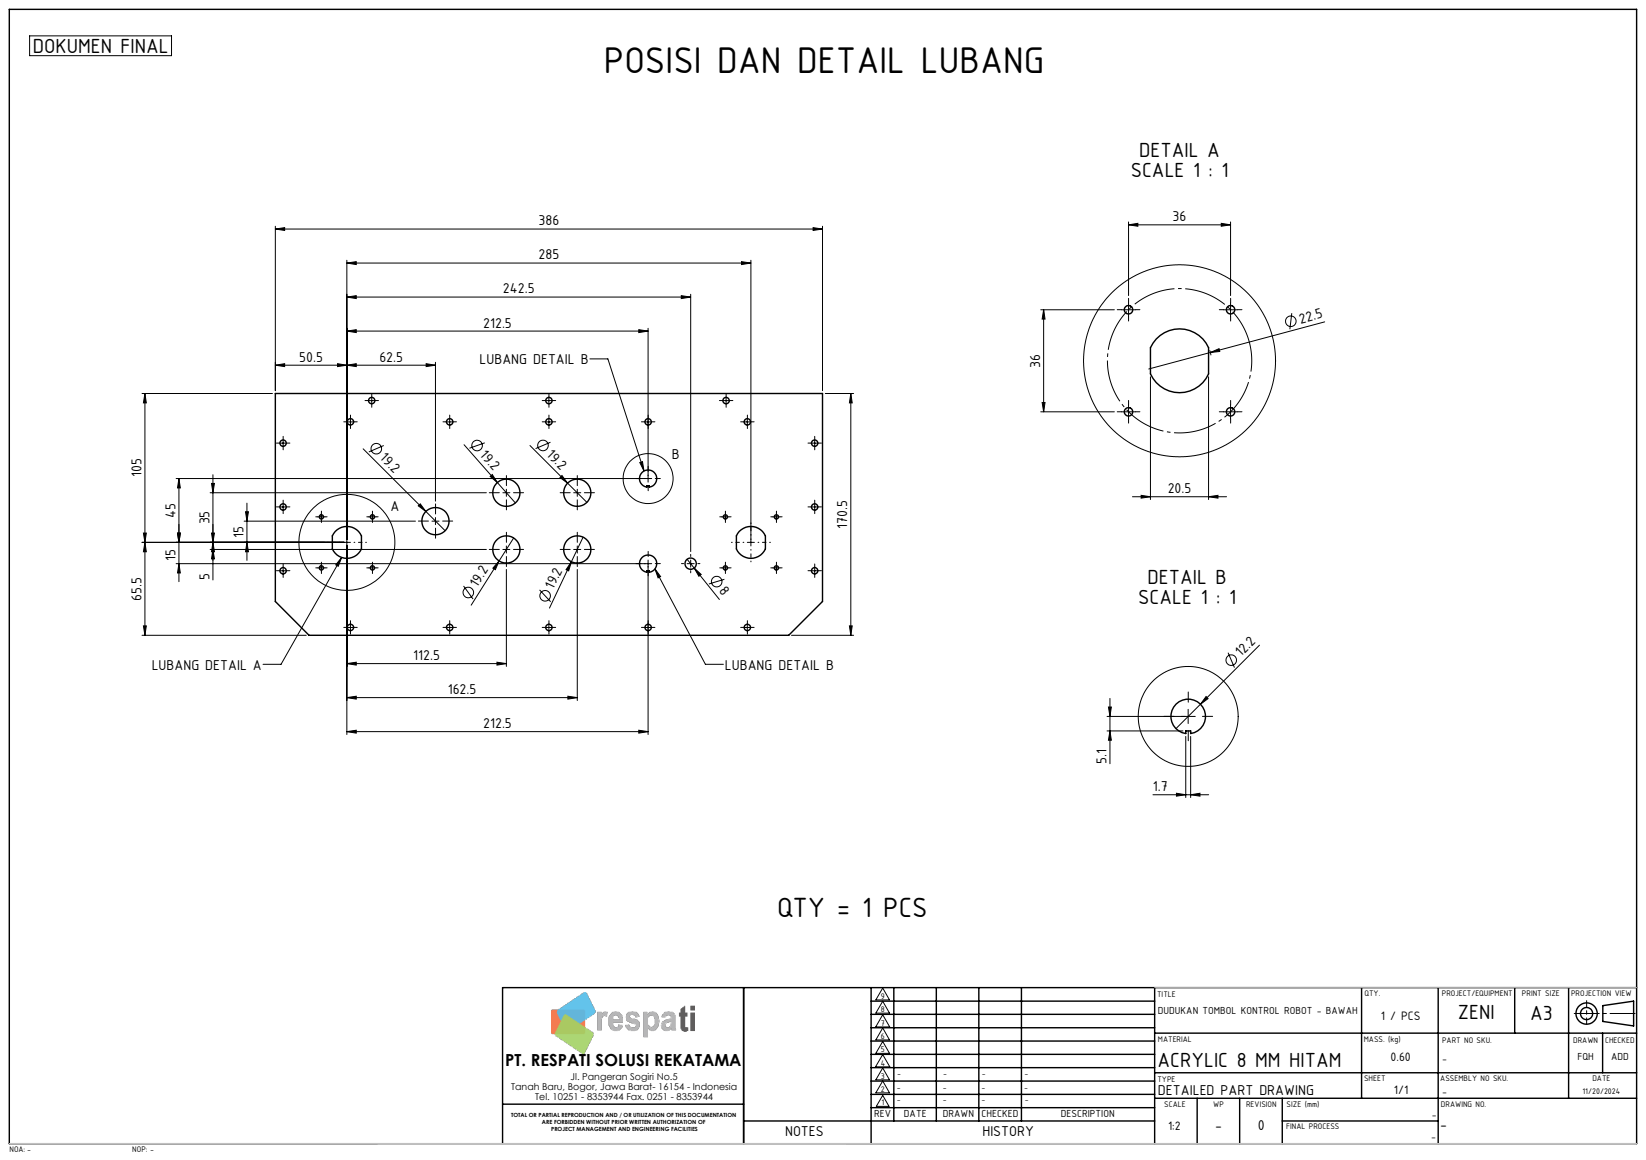
[picture p38: page 1]
LUBANG DETAIL A; LUBANG DETAIL B; DETAIL A SCALE 1 : 1; DETAIL B SCALE 1 : 1; QTY = 1 PCS; REV DATE; DRAWN CHECKED; DESCRIPTION; REVISION; DRAWING NO.; PROJECTION VIEW; FQH; ADD ACRYLIC 8 MM HITAM; PRINT SIZE; MASS. (kg); SIZE (mm); NOA: -; NOP: -; 1 / PCS; DOKUMEN FINAL

POSISI DAN DETAIL LUBANG

TITLE
DUDUKAN TOMBOL KONTROL ROBOT - BAWAH
DETAILED PART DRAWING
SCALE
FINAL PROCESS

PART NO SKU.

PT. RESPATI SOLUSI REKATAMA

Jl. Pangeran Sogiri No.5
Tel. 10251 - 8353944 Fax. 0251 - 8353944

ASSEMBLY NO SKU.

Tanah Baru, Bogor, Jawa Barat- 16154 - Indonesia

TOTAL OR PARTIAL REPRODUCTION AND / OR UTILIZATION OF THIS DOCUMENTATION

ARE FORBIDDEN WITHOUT PRIOR WRITTEN AUTHORIZATION OF
PROJECT MANAGEMENT AND ENGINEERING FACILITIES
