mfauzansyarif/ugv-robot/(list of files, drawings)

Other design files:
Schematic/STM32G474_Board/EasyEDA/PCBLIB_NUCLEO-G474RE_2026-07-27.json
Schematic/STM32G474_Board/EasyEDA/SCHLIB_NUCLEO-(STM32G474RET6)_2026-07-27.json
