mfauzansyarif/ugv-robot/Schematic/STM32G474_Board/STM32G474_Board.kicad_pcb

## KiCad design Schematic/STM32G474_Board/STM32G474_Board.kicad_pcb (2026-07-31)

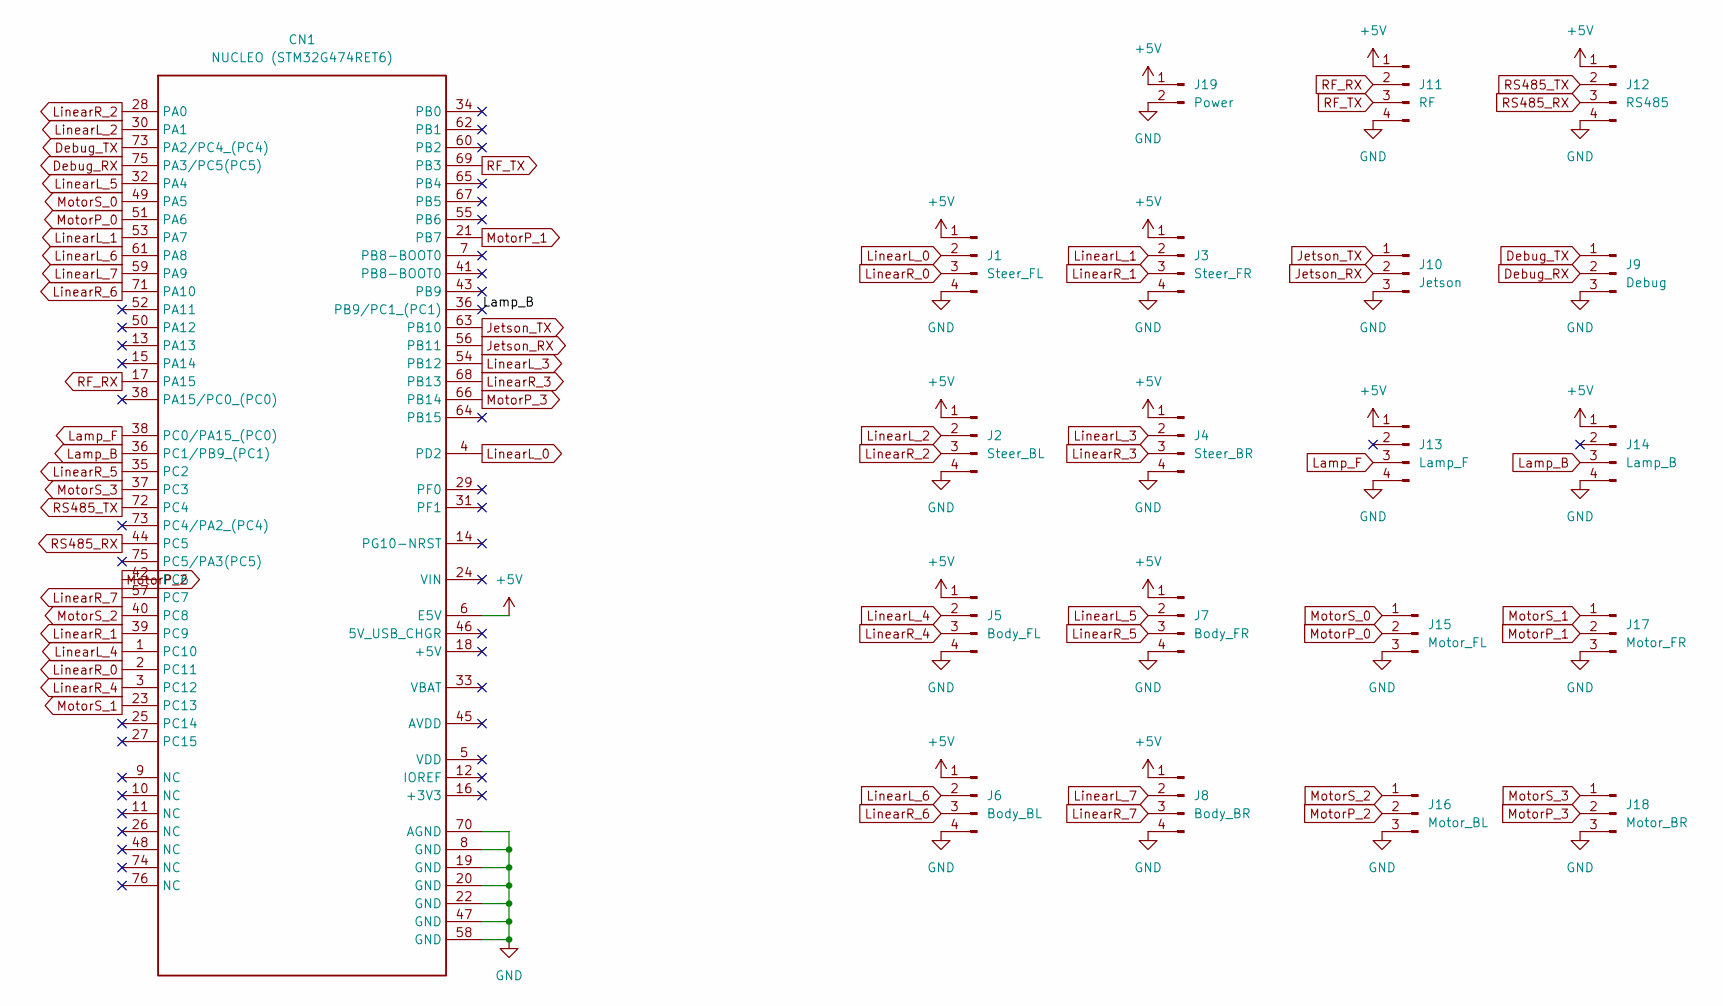
[picture p39: schematic STM32G474_Board.kicad_sch, STM32G474RE Board - UGV]

Parts:
CN1: NUCLEO (STM32G474RET6); NUCLEO-G474RE; Manufacturer Part NUCLEO-G474RE
J1: Steer_FL; JST_XH_B4B-XH-A_1x04_P2.50mm_Vertical
J2: Steer_BL; JST_XH_B4B-XH-A_1x04_P2.50mm_Vertical
J3: Steer_FR; JST_XH_B4B-XH-A_1x04_P2.50mm_Vertical
J4: Steer_BR; JST_XH_B4B-XH-A_1x04_P2.50mm_Vertical
J5: Body_FL; JST_XH_B4B-XH-A_1x04_P2.50mm_Vertical
J6: Body_BL; JST_XH_B4B-XH-A_1x04_P2.50mm_Vertical
J7: Body_FR; JST_XH_B4B-XH-A_1x04_P2.50mm_Vertical
J8: Body_BR; JST_XH_B4B-XH-A_1x04_P2.50mm_Vertical
J9: Debug; JST_XH_B3B-XH-A_1x03_P2.50mm_Vertical
J10: Jetson; JST_XH_B3B-XH-A_1x03_P2.50mm_Vertical
J11: RF; JST_XH_B4B-XH-A_1x04_P2.50mm_Vertical
J12: RS485; JST_XH_B4B-XH-A_1x04_P2.50mm_Vertical
J13: Lamp_F; JST_XH_B4B-XH-A_1x04_P2.50mm_Vertical
J14: Lamp_B; JST_XH_B4B-XH-A_1x04_P2.50mm_Vertical
J15: Motor_FL; JST_XH_B3B-XH-A_1x03_P2.50mm_Vertical
J16: Motor_BL; JST_XH_B3B-XH-A_1x03_P2.50mm_Vertical
J17: Motor_FR; JST_XH_B3B-XH-A_1x03_P2.50mm_Vertical
J18: Motor_BR; JST_XH_B3B-XH-A_1x03_P2.50mm_Vertical
J19: Power; JST_XH_B2B-XH-A_1x02_P2.50mm_Vertical

Connections:
+5V: CN1.6 (E5V), J1.1, J2.1, J3.1, J4.1, J5.1, J6.1, J7.1, J8.1, J11.1, J12.1, J13.1, J14.1, J19.1
Debug_RX: CN1.75 (PA3/PC5(PC5)), J9.2
Debug_TX: CN1.73 (PA2/PC4_(PC4)), J9.1
GND: CN1.8 (GND), CN1.19 (GND), CN1.20 (GND), CN1.22 (GND), CN1.47 (GND), CN1.58 (GND), CN1.70 (AGND), J1.4, J2.4, J3.4, J4.4, J5.4, J6.4, J7.4, J8.4, J9.3, J10.3, J11.4, J12.4, J13.4, J14.4, J15.3, J16.3, J17.3, J18.3, J19.2
Jetson_RX: CN1.56 (PB11), J10.2
Jetson_TX: CN1.63 (PB10), J10.1
Lamp_B: CN1.36 (PC1/PB9_(PC1)), J14.3
Lamp_F: CN1.38 (PC0/PA15_(PC0)), J13.3
LinearL_0: CN1.4 (PD2), J1.2
LinearL_1: CN1.53 (PA7), J3.2
LinearL_2: CN1.30 (PA1), J2.2
LinearL_3: CN1.54 (PB12), J4.2
LinearL_4: CN1.1 (PC10), J5.2
LinearL_5: CN1.32 (PA4), J7.2
LinearL_6: CN1.61 (PA8), J6.2
LinearL_7: CN1.59 (PA9), J8.2
LinearR_0: CN1.2 (PC11), J1.3
LinearR_1: CN1.39 (PC9), J3.3
LinearR_2: CN1.28 (PA0), J2.3
LinearR_3: CN1.68 (PB13), J4.3
LinearR_4: CN1.3 (PC12), J5.3
LinearR_5: CN1.35 (PC2), J7.3
LinearR_6: CN1.71 (PA10), J6.3
LinearR_7: CN1.57 (PC7), J8.3
MotorP_0: CN1.51 (PA6), J15.2
MotorP_1: CN1.21 (PB7), J17.2
MotorP_2: CN1.42 (PC6), J16.2
MotorP_3: CN1.66 (PB14), J18.2
MotorS_0: CN1.49 (PA5), J15.1
MotorS_1: CN1.23 (PC13), J17.1
MotorS_2: CN1.40 (PC8), J16.1
MotorS_3: CN1.37 (PC3), J18.1
RF_RX: CN1.17 (PA15), J11.2
RF_TX: CN1.69 (PB3), J11.3
RS485_RX: CN1.44 (PC5), J12.3
RS485_TX: CN1.72 (PC4), J12.2

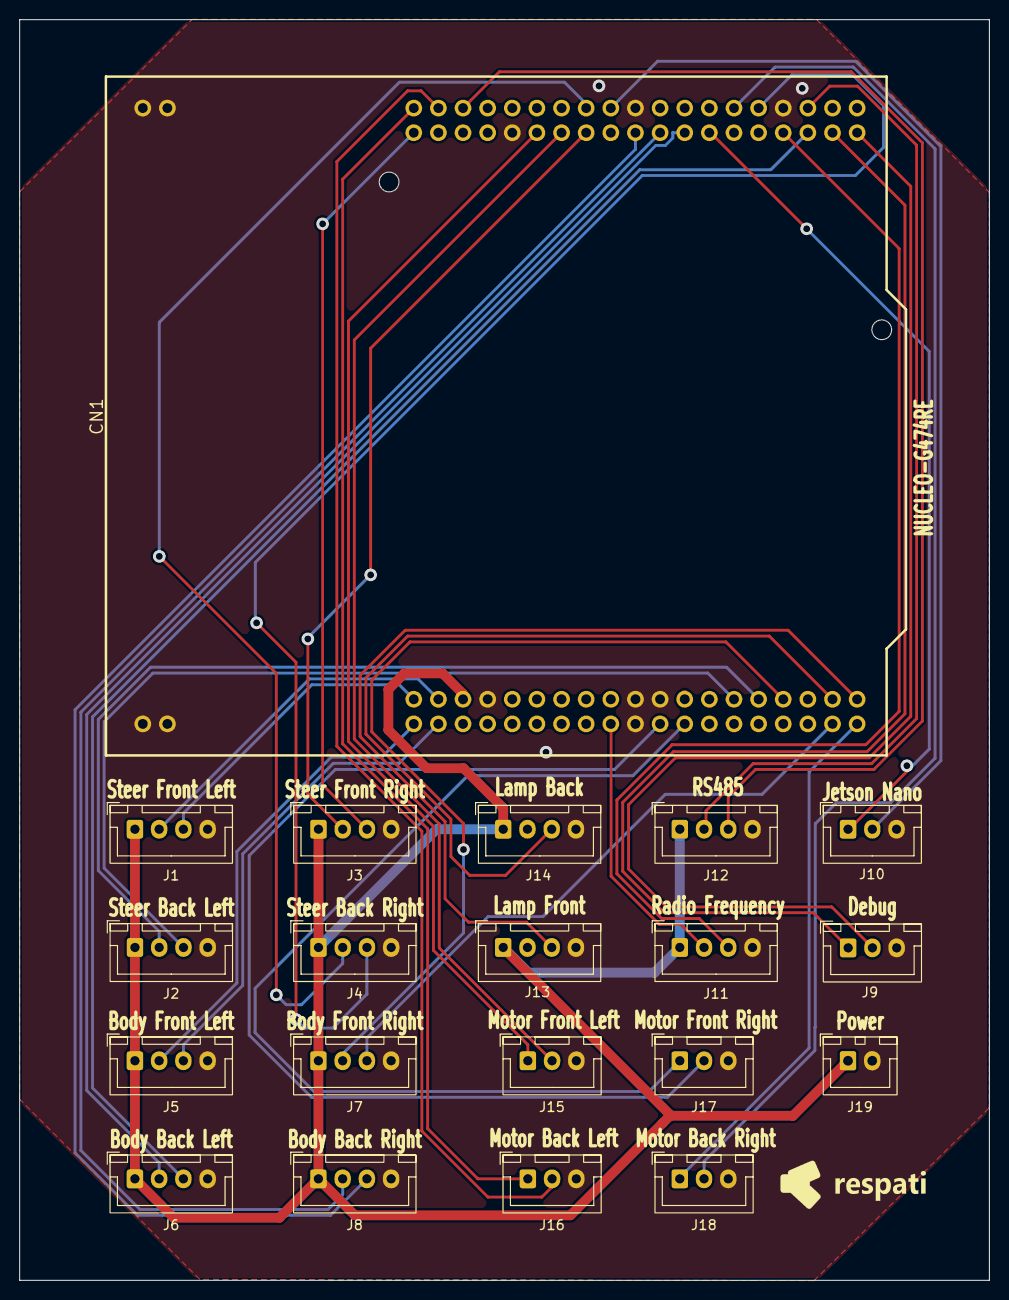
[picture p40: board STM32G474_Board.kicad_pcb from above]

Board: 2 copper layers, 100.0 x 130.0 mm, 20 parts (0 on the bottom side), 36 nets.
