mfauzansyarif/ugv-robot/Code/ArduinoMegaPro/ArduinoMegaPro.ino

/* 
 * Panel GCS Arduino Mega Pro
 * (ASCII, 12 field dipisah spasi, "\n"-terminated, 57600 baud, 20Hz):
 * "<X> <Y> <lrf> <zoomin> <zoomout> <bodyup> <bodydown> <lampu> <cam_atas> <cam_kanan> <cam_bawah> <cam_kiri>\n"
*/

const int PIN_JOY_VRX = A1;   // X - steering
const int PIN_JOY_VRY = A0;   // Y - speed

const int PIN_LRF         = 3;
const int PIN_ZOOM_NAIK   = 5;   // zoomin
const int PIN_ZOOM_TURUN  = 7;   // zoomout
const int PIN_BODY_NAIK   = 9;   // bodyup
const int PIN_BODY_TURUN  = 11;  // bodydown
const int PIN_LAMPU_UTAMA = 25;  // lampu toggle
const int PIN_KAM_ATAS    = 15;  // cam_atas
const int PIN_KAM_BAWAH   = 17;  // cam_bawah
const int PIN_KAM_KIRI    = 19;  // cam_kiri
const int PIN_KAM_KANAN   = 23;  // cam_kanan

const int PIN_LAMPU_INDIKATOR = 13;  // OUTPUT

const unsigned long KIRIM_INTERVAL_MS = 50;  // 20Hz
unsigned long waktuKirimTerakhir = 0;

const int RAW_MIN         = 100; //Range Mentah min
const int RAW_MAX         = 900; //Range Mentah max
const int RAW_TENGAH      = (RAW_MIN + RAW_MAX) / 2;  // Deadzone
const int JUMLAH_SAMPLE   = 8;      // Averaging
const int LEBAR_DEADZONE  = 15;     // Deadzone Range
const float ALPHA_SMOOTH  = 0.3f;   // Makin kecil makin smooth tapi makin lambat respon

float vrxSmooth = RAW_TENGAH;
float vrySmooth = RAW_TENGAH;

int bacaAxis0_1000(int pin, float *nilaiSmooth) {
    long total = 0;
    for (int i = 0; i < JUMLAH_SAMPLE; i++) {
        total += analogRead(pin);
        delayMicroseconds(50);
    }
    int rataRata = total / JUMLAH_SAMPLE;

    *nilaiSmooth = (ALPHA_SMOOTH * rataRata) + ((1.0f - ALPHA_SMOOTH) * (*nilaiSmooth));
    int rawHasil = (int)(*nilaiSmooth);

    if (abs(rawHasil - RAW_TENGAH) < LEBAR_DEADZONE) {
        rawHasil = RAW_TENGAH;
        *nilaiSmooth = RAW_TENGAH;
    }

    int hasil0_1000 = map(rawHasil, RAW_MIN, RAW_MAX, 0, 1000);
    return constrain(hasil0_1000, 0, 1000);
}

int bacaTombol(int pin) {
    return (digitalRead(pin) == LOW) ? 1 : 0;
}

/* Tombol pantilt (cam_atas/kanan/bawah/kiri) Normally Closed */
int bacaTombolNC(int pin) {
    return (digitalRead(pin) == HIGH) ? 1 : 0;
}

void setup() {
    Serial.begin(57600);

    pinMode(PIN_LRF, INPUT_PULLUP);
    pinMode(PIN_ZOOM_NAIK, INPUT_PULLUP);
    pinMode(PIN_ZOOM_TURUN, INPUT_PULLUP);
    pinMode(PIN_BODY_NAIK, INPUT_PULLUP);
    pinMode(PIN_BODY_TURUN, INPUT_PULLUP);
    pinMode(PIN_LAMPU_UTAMA, INPUT_PULLUP);
    pinMode(PIN_KAM_ATAS, INPUT_PULLUP);
    pinMode(PIN_KAM_BAWAH, INPUT_PULLUP);
    pinMode(PIN_KAM_KIRI, INPUT_PULLUP);
    pinMode(PIN_KAM_KANAN, INPUT_PULLUP);
    pinMode(PIN_LAMPU_INDIKATOR, OUTPUT);
}

void loop() {
    if (millis() - waktuKirimTerakhir >= KIRIM_INTERVAL_MS) {
        waktuKirimTerakhir = millis();

        int x = bacaAxis0_1000(PIN_JOY_VRX, &vrxSmooth);
        int y = bacaAxis0_1000(PIN_JOY_VRY, &vrySmooth);

        int lrf       = bacaTombol(PIN_LRF);
        int zoomin    = bacaTombol(PIN_ZOOM_NAIK);
        int zoomout   = bacaTombol(PIN_ZOOM_TURUN);
        int bodyup    = bacaTombol(PIN_BODY_NAIK);
        int bodydown  = bacaTombol(PIN_BODY_TURUN);
        int lampu     = bacaTombol(PIN_LAMPU_UTAMA);
        digitalWrite(PIN_LAMPU_INDIKATOR, lampu ? HIGH : LOW);

        int camAtas   = bacaTombolNC(PIN_KAM_ATAS);
        int camKanan  = bacaTombolNC(PIN_KAM_KANAN);
        int camBawah  = bacaTombolNC(PIN_KAM_BAWAH);
        int camKiri   = bacaTombolNC(PIN_KAM_KIRI);

        Serial.print(x);         Serial.print(' ');
        Serial.print(y);         Serial.print(' ');
        Serial.print(lrf);       Serial.print(' ');
        Serial.print(zoomin);    Serial.print(' ');
        Serial.print(zoomout);   Serial.print(' ');
        Serial.print(bodyup);    Serial.print(' ');
        Serial.print(bodydown);  Serial.print(' ');
        Serial.print(lampu);     Serial.print(' ');
        Serial.print(camAtas);   Serial.print(' ');
        Serial.print(camKanan);  Serial.print(' ');
        Serial.print(camBawah);  Serial.print(' ');
        Serial.println(camKiri);
    }
}
