mfauzansyarif/ugv-robot/ROS2/ros2_ws/src/ugv_robot/ugv_robot/core_node.py

"""
Core Node
==========
SATU-SATUNYA tempat ada logic/keputusan di seluruh sistem.

Alur: subscribe data mentah dari STM32 Interface (/stm32/gcs_relay,
/stm32/lrf_status, /stm32/health) -> OLAH jadi command final -> publish
ke /stm32/command.

Publish dipicu tiap kali /stm32/gcs_relay masuk (1 up-frame = 1 keputusan),
BUKAN pakai timer sendiri - biar ritmenya ngikut data asli dari GCS.

Index actuator (act[0..7]):
  0 = Steer Depan Kiri     4 = FBody Kiri
  1 = Steer Depan Kanan    5 = FBody Kanan
  2 = Steer Belakang Kiri  6 = BBody Kiri
  3 = Steer Belakang Kanan 7 = BBody Kanan
"""

import time

import rclpy
from rclpy.node import Node

from ugv_robot_msgs.msg import StmCommand, GcsRelay, LrfStatus, Health, PersonDetection

LRF_IDLE = 0
LRF_BACA_JARAK = 1
LRF_POINTER_ON = 2
LRF_POINTER_OFF = 3

ACT_STEER_DEPAN_KIRI = 0
ACT_STEER_DEPAN_KANAN = 1
ACT_STEER_BELAKANG_KIRI = 2
ACT_STEER_BELAKANG_KANAN = 3
ACT_FBODY_KIRI = 4
ACT_FBODY_KANAN = 5
ACT_BBODY_KIRI = 6
ACT_BBODY_KANAN = 7

# Arti motor_individual_id (di-REDEFINE dari GCS) - 8 actuator individual
# (1-8), PLUS 1 mode pasangan (9) buat steer belakang kiri+kanan gerak
# BERLAWANAN bareng (pola sama kayak logic steer normal), dipakai kalau
# operator mau belok cepat pakai tombol individual tanpa nunggu threshold
# joystick x_joy1.
ID_NORMAL = 0
ID_STEER_DEPAN_KIRI = 1
ID_STEER_DEPAN_KANAN = 2
ID_STEER_BELAKANG_KIRI = 3
ID_STEER_BELAKANG_KANAN = 4
ID_FBODY_KIRI = 5
ID_FBODY_KANAN = 6
ID_BBODY_KIRI = 7
ID_BBODY_KANAN = 8
ID_STEER_BELAKANG_PASANGAN = 9
ID_STEER_DEPAN_PASANGAN = 10

DAMPER_GAS_PER_SIKLUS = 5
DAMPER_REM_PER_SIKLUS = 15

ACT_KALIBRASI = [0] * 8
ACT_KALIBRASI[ACT_STEER_DEPAN_KIRI] = 100
ACT_KALIBRASI[ACT_STEER_DEPAN_KANAN] = -100
ACT_KALIBRASI[ACT_STEER_BELAKANG_KIRI] = 100
ACT_KALIBRASI[ACT_STEER_BELAKANG_KANAN] = -100
ACT_KALIBRASI[ACT_FBODY_KIRI] = 100
ACT_KALIBRASI[ACT_FBODY_KANAN] = 100
ACT_KALIBRASI[ACT_BBODY_KIRI] = 100
ACT_KALIBRASI[ACT_BBODY_KANAN] = 100


def tanda(nilai):
    if nilai > 0:
        return 1
    if nilai < 0:
        return -1
    return 0


class CoreNode(Node):
    def __init__(self):
        super().__init__('core_node')

        self.declare_parameter('steer_threshold', 30)
        self.steer_threshold = self.get_parameter('steer_threshold').value

        self.declare_parameter('kalibrasi_maks_durasi_sec', 15.0)
        self.kalibrasi_maks_durasi_sec = self.get_parameter('kalibrasi_maks_durasi_sec').value

        self._lrf_sebelumnya = 0
        self._kalibrasi_mulai = None
        self._kalibrasi_timeout_sudah_lapor = False
        self._speed_terakhir = 0

        self._lrf_status = LrfStatus()
        self._health = Health()
        self._health.stm32_status = 1
        self._deteksi = PersonDetection()

        self.create_subscription(GcsRelay, '/stm32/gcs_relay',
                                 self._olah_dan_publish, 10)
        self.create_subscription(LrfStatus, '/stm32/lrf_status',
                                 self._callback_lrf_status, 10)
        self.create_subscription(Health, '/stm32/health',
                                 self._callback_health, 10)
        self.create_subscription(PersonDetection, '/vision/deteksi',
                                 self._callback_deteksi, 10)

        self.pub_command = self.create_publisher(StmCommand, '/stm32/command', 10)

        self.get_logger().info('Core Node siap')

    def _callback_lrf_status(self, msg: LrfStatus):
        self._lrf_status = msg

    def _callback_health(self, msg: Health):
        self._health = msg

    def _callback_deteksi(self, msg: PersonDetection):
        self._deteksi = msg

    def _olah_dan_publish(self, relay: GcsRelay):
        cmd = StmCommand()

        if relay.estop:
            cmd.speed = 0
            self._speed_terakhir = 0
            cmd.act = [0] * 8
            cmd.f_lamp = 0
            cmd.b_lamp = 0
            cmd.b_lamp_mode = 0
            cmd.pantilt_horizontal = 0
            cmd.pantilt_vertical = 0
            cmd.kamera_zoom = 0
            cmd.slip_ring = 0
            cmd.lrf_trigger = LRF_POINTER_OFF
            self._isi_gcs_reply(cmd)
            self._lrf_sebelumnya = relay.lrf
            self.pub_command.publish(cmd)
            return

        if self._kalibrasi_masih_boleh(relay.kalibrasi):
            cmd.speed = 0
            self._speed_terakhir = 0
            cmd.act = list(ACT_KALIBRASI)
            cmd.f_lamp = relay.f_lamp
            cmd.b_lamp = relay.f_lamp
            cmd.b_lamp_mode = relay.b_lamp
            cmd.pantilt_horizontal = 0
            cmd.pantilt_vertical = 0
            cmd.kamera_zoom = 0
            cmd.slip_ring = relay.slip_ring
            cmd.lrf_trigger = LRF_POINTER_OFF
            self._isi_gcs_reply(cmd)
            self._lrf_sebelumnya = relay.lrf
            self.pub_command.publish(cmd)
            return

        cmd.speed = self._damper_speed(relay.y_joy1)
        cmd.act = self._hitung_actuator(relay)

        cmd.f_lamp = relay.f_lamp
        cmd.b_lamp = relay.f_lamp
        cmd.b_lamp_mode = relay.b_lamp

        cmd.pantilt_horizontal = tanda(relay.x_joy2)
        cmd.pantilt_vertical = tanda(relay.y_joy2)

        cmd.kamera_zoom = relay.zoom
        cmd.slip_ring = relay.slip_ring

        cmd.lrf_trigger = self._hitung_lrf_trigger(relay.lrf)

        self._isi_gcs_reply(cmd)

        self.pub_command.publish(cmd)

    def _kalibrasi_masih_boleh(self, kalibrasi_sekarang):
        if not kalibrasi_sekarang:
            self._kalibrasi_mulai = None
            self._kalibrasi_timeout_sudah_lapor = False
            return False

        sekarang = time.time()
        if self._kalibrasi_mulai is None:
            self._kalibrasi_mulai = sekarang

        durasi = sekarang - self._kalibrasi_mulai
        if durasi >= self.kalibrasi_maks_durasi_sec:
            if not self._kalibrasi_timeout_sudah_lapor:
                self.get_logger().warn(
                    f'Kalibrasi otomatis DIMATIKAN - kelewat batas '
                    f'{self.kalibrasi_maks_durasi_sec}s (toggle GCS lupa dilepas?)')
                self._kalibrasi_timeout_sudah_lapor = True
            return False

        return True

    def _hitung_actuator(self, relay: GcsRelay):
        act = [0] * 8

        if relay.motor_individual_id != ID_NORMAL:
            arah = relay.motor_individual_arah
            mid = relay.motor_individual_id

            if mid == ID_STEER_DEPAN_KIRI:
                act[ACT_STEER_DEPAN_KIRI] = 100 * arah
            elif mid == ID_STEER_DEPAN_KANAN:
                act[ACT_STEER_DEPAN_KANAN] = 100 * arah
            elif mid == ID_STEER_BELAKANG_KIRI:
                act[ACT_STEER_BELAKANG_KIRI] = 100 * arah
            elif mid == ID_STEER_BELAKANG_KANAN:
                act[ACT_STEER_BELAKANG_KANAN] = 100 * arah
            elif mid == ID_FBODY_KIRI:
                act[ACT_FBODY_KIRI] = 100 * arah
            elif mid == ID_FBODY_KANAN:
                act[ACT_FBODY_KANAN] = 100 * arah
            elif mid == ID_BBODY_KIRI:
                act[ACT_BBODY_KIRI] = 100 * arah
            elif mid == ID_BBODY_KANAN:
                act[ACT_BBODY_KANAN] = 100 * arah
            elif mid == ID_STEER_BELAKANG_PASANGAN:
                # Kiri & kanan BERLAWANAN, pola sama kayak logic steer
                # normal (bukan gerak sama arah kayak kalibrasi) - biar
                # bisa dipakai buat belok cepat lewat tombol individual.
                act[ACT_STEER_BELAKANG_KIRI] = -100 * arah
                act[ACT_STEER_BELAKANG_KANAN] = 100 * arah
            elif mid == ID_STEER_DEPAN_PASANGAN:
                act[ACT_STEER_DEPAN_KIRI] = -100 * arah
                act[ACT_STEER_DEPAN_KANAN] = 100 * arah

            return act

        if relay.x_joy1 > self.steer_threshold:
            arah_steer = 1
        elif relay.x_joy1 < -self.steer_threshold:
            arah_steer = -1
        else:
            arah_steer = 0

        if arah_steer != 0:
            act[ACT_STEER_DEPAN_KIRI] = -100 * arah_steer
            act[ACT_STEER_DEPAN_KANAN] = 100 * arah_steer
            act[ACT_STEER_BELAKANG_KIRI] = -100 * arah_steer
            act[ACT_STEER_BELAKANG_KANAN] = 100 * arah_steer

        if relay.body_up_down != 0:
            nilai_body = 100 * tanda(relay.body_up_down)
            act[ACT_FBODY_KIRI] = nilai_body
            act[ACT_FBODY_KANAN] = nilai_body
            act[ACT_BBODY_KIRI] = nilai_body
            act[ACT_BBODY_KANAN] = nilai_body
        return act

    def _damper_speed(self, target):
        if abs(target) > abs(self._speed_terakhir):
            maks_delta = DAMPER_GAS_PER_SIKLUS
        else:
            maks_delta = DAMPER_REM_PER_SIKLUS

        delta = target - self._speed_terakhir
        delta = max(-maks_delta, min(maks_delta, delta))
        self._speed_terakhir += delta
        return self._speed_terakhir

    def _hitung_lrf_trigger(self, lrf_sekarang):
        if self._lrf_sebelumnya == 1 and lrf_sekarang == 0:
            trigger = LRF_BACA_JARAK
        elif lrf_sekarang == 1:
            trigger = LRF_POINTER_ON
        else:
            trigger = LRF_POINTER_OFF

        self._lrf_sebelumnya = lrf_sekarang
        return trigger

    def _isi_gcs_reply(self, cmd: StmCommand):
        cmd.gcs_reply_stm32_status = self._health.stm32_status
        cmd.gcs_reply_lrf_status = self._lrf_status.status
        cmd.gcs_reply_lrf_lsb = self._lrf_status.jarak_lsb
        cmd.gcs_reply_lrf_msb = self._lrf_status.jarak_msb
        cmd.gcs_reply_box_terdeteksi = 1 if self._deteksi.terdeteksi else 0
        cmd.gcs_reply_box_pusat_x = int(self._deteksi.pusat_x)
        cmd.gcs_reply_box_pusat_y = int(self._deteksi.pusat_y)
        cmd.gcs_reply_box_lebar = int(self._deteksi.lebar)
        cmd.gcs_reply_box_tinggi = int(self._deteksi.tinggi)


def main(args=None):
    rclpy.init(args=args)
    node = CoreNode()
    try:
        rclpy.spin(node)
    except KeyboardInterrupt:
        pass
    finally:
        node.destroy_node()
        rclpy.shutdown()


if __name__ == '__main__':
    main()
