mfauzansyarif/ugv-robot/(commit log)

2026-07-01 Tambah folder Lidikzi-robot-main dengan kode dan dokumentasi
    [logbook.csv]
2026-07-01 Rapihkan struktur folder
    [logbook.csv]
2026-07-02 ini isi jetson yg kita copy
2026-07-02 Rename relay -> forwarder
2026-07-03 Tambah code testcode serial ke stm32 dan ros2 (belum works)
2026-07-06 Testcode servo driver, datasheet servo driver
2026-07-06 kode control 2 motor dengana arduino mega
2026-07-06 ini tabel pinout
    [wiring_motor_blac.xlsx]
2026-07-06 Tambah testcode python ke stm32 untuk memutar motor dengan format data baru sesuai di dokumentasi>STM32_BRIEF.md
2026-07-07 test control motor python>stm32
2026-07-07 kode stm32 sementara
2026-07-07 python test control motor lewat stm32 berhasil
2026-07-07 Migrasi ROS2 bridge & keyboard teleop ke protokol motor AC baru
    stm32_bridge.py dan keyboard_teleop.py sekarang pakai format "M <speed1..4>"
    (protokol yang sama dengan Testcode/test_ac_motors_stm32.py) menggantikan
    protokol 6-field lama dari firmware v1. Baudrate default diturunkan ke 57600
    sesuai temuan empiris sebelumnya bahwa 115200 bikin data korup.
2026-07-08 tescode pantilt camera lrf
2026-07-08 test camera zoom focus berhasil PELCOD
2026-07-09 Draw io tampilan kasar GCS
    [ugv-robot.kicad_pcb, ugv-robot.kicad_sch]
2026-07-13 stm32 interface
2026-07-16 kode stm32 final #1 dan debug pyserialnya
2026-07-16 ROS2: stm32 node works
2026-07-17 Arduino Mega Pro brief
2026-07-20 KiCad GCS (belum selesai)
    [ugv-robot.kicad_sch]
2026-07-21 jetson spi testcode
2026-07-27 Add STM32G474 KiCad hardware design files
    [STM32G474.kicad_pcb, STM32G474.kicad_sch]
2026-07-27 Update STM32G474 schematic with MCU and USB buck sheets
    [MCU_sch.kicad_sch, STM32G474.kicad_pcb, STM32G474.kicad_sch, usbbuck_sch.kicad_sch]
2026-07-27 STM32 G474RE Done
    [motorugv Debug.cfg]
2026-07-27 ros2 update tanpa arm
2026-07-27 Update GCS app, tambah G474 board/hardware, dan STM32 ROS2 interface
    [PCBLIB_NUCLEO-G474RE_2026-07-27.json, SCHLIB_NUCLEO-(STM32G474RET6)_2026-07-27.json, STM32G474_Board.kicad_pcb, STM32G474_Board.kicad_sch, ugv-robot.kicad_sch, ugv.kicad_sch, untitled.kicad_sch]
2026-07-29 remove widennarrow
    [STM32G474_Board.kicad_pcb]
2026-07-31 Ignore Python __pycache__/.pyc, tambah test STM32 palsu g474, update brief ROS2
2026-08-03 Reorganize project into Rapih/ folder structure
    Move final Arduino, GCS app, and STM32 firmware source into Rapih/Code/,
    and datasheets/schematics into Rapih/Datasheet/ and Rapih/Schematic/,
    consolidating scattered old locations (gcs_app/, STM32Cube/motorugv_G474RE/,
    Testcode/megapro_gcs/, Hardware/STM32G474_Board/) for a cleaner layout.
    [PCBLIB_NUCLEO-G474RE_2026-07-27.json, SCHLIB_NUCLEO-(STM32G474RET6)_2026-07-27.json, STM32G474_Board.kicad_pcb, STM32G474_Board.kicad_sch, bom.csv, designators.csv, positions.csv, ugv-robot.kicad_sch]
2026-08-03 Fix bug individual motor control
    [main_window.py, motor_linear_dialog.py]
2026-08-05 camera fix
2026-08-11 fix menu kalibrasi + checksum
    [core_node.py, main.c, main.h, main_window.py, motor_linear_dialog.py, motorugv_G474RE.ioc, stm32_interface_node.py]
2026-08-13 update app
    [STM32G474_Board.kicad_sch]
2026-08-18 Reorganisasi struktur folder project
    Pindahin Testcode/, dokumentasi/, jetson/, KiCad/, codeModeROS/ ke lokasi
    baru di bawah Rapih/ (dan arsipin sebagian yang udah gak dipakai ke
    GKDIPAKE/), biar struktur project lebih rapi.
    Selain itu ada fix kecil di stm32f1xx_hal_msp.c: JTAG di-disable tapi
    SWD tetap jalan (__HAL_AFIO_REMAP_SWJ_NOJTAG), buat bebasin pin
    PA15/PB3/PB4 tanpa kehilangan debug access lewat SWD.
    [logbook.csv, ugv-robot.kicad_pcb, ugv-robot.kicad_sch, ugv.kicad_sch, untitled.kicad_sch, wiring_motor_blac.xlsx]
2026-08-18 Resolve merge, tambah test loopback RS485, ignore build/ CMake
    [main_window.py, motor_linear_dialog.py, test_bridge_lrf_stm32.py, test_bus_pantilt_kamera_lrf.py, test_gcs_lengkap_manual_g474.py, test_gcs_manual_g474.py, test_jetson_manual_g474.py, test_loopback_rs485_2_port.py]
2026-08-21 arduino mega
2026-08-21 Rapikan struktur repo, rename+rapikan Test Code, update dokumentasi
    Konsolidasi seluruh source aktif (sebelumnya tersebar di Rapih/, root
    ROS2/, root Testcode/, dan ~13 folder arsip lama) jadi satu struktur
    flat di root repo. Rename semua file test/firmware-snapshot di "Test
    Code/" biar konsisten & jelas, kompakin comment/docstring-nya, dan
    benerin referensi path yang basi ke folder-folder yang udah dipindah.
    Update README & panduan ROS2 biar sesuai kondisi UGV sekarang: status
    LRF/slip-ring/kalibrasi/deteksi-YOLO, MCU bridge yang lagi rusak, dan
    alur jalanin ROS2 lewat Docker auto-start (bukan colcon build manual).
    [MCU_sch.kicad_sch, PCBLIB_NUCLEO-G474RE_2026-07-27.json, SCHLIB_NUCLEO-(STM32G474RET6)_2026-07-27.json, STM32G474.kicad_pcb, STM32G474.kicad_sch, STM32G474_Board.kicad_pcb, STM32G474_Board.kicad_sch, bom.csv]
2026-08-21 Hapus NucleoG474RE - Copy (project bench-test isolasi bug motor AC)
    Duplikat ini udah gak dipakai lagi, isolasi bug pulsa motor AC yang
    jadi tujuannya sudah selesai (root cause ketemu di sisi test script,
    bukan firmware).
    [main.c, main.h, motorugv_G474RE.ioc]
